VianneyRousset/IRemote/todo.md

# Vianney
- report:	Layout (direct upload), Intro/objectifs, Notation, Stages(schema)
- Kicad:	reception, decoding, relay 

# Michael
- report:	Stages, testing
- Kicad:	Encoder, (driver diode), filtering

# Report
- chaque stage est séparé en:
	1. Objectif et choix
	1. Implementation
	1. Dimensionnement
