VianneyRousset/IRemote/rapport/main.tex

\documentclass[french]{layout/Report}
\usepackage{layout/Report}
\usepackage{layout/ReportFrontPage}

\usepackage{pgf,tikz,textcomp}
\usepackage[section]{placeins}
\usepackage{romannum}
\usetikzlibrary{arrows}
\usepackage{mathtools}
\usepackage{array}
\usepackage{color}
\usepackage{graphicx}
\usepackage{todonotes}
\usepackage{enumitem}
\usepackage{MnSymbol} % rectangle symbol
\usepackage{pdfpages} % for appendix

\DeclarePairedDelimiter\abs{\lvert}{\rvert}%

\begin{document}

\pagenumbering{arabic}

\pagebreak

\frontpage{Télécommande à 1 canal par infrarouge}
%-------------------------------------------------------------------------------
\section{Introduction}
Le but est de concevoir un système d'émission - réception infrarouge avec adressage
permettant d'enclencher et déclencher un relais optique.

%-------------------------------------------------------------------------------
\section{Structure générale et principe}

Le système est divisé en 5 étages pour faciliter le développement et la testabilité:

\begin{description}[leftmargin=!,labelwidth=4cm, labelindent=\parindent]
	\item[Générateur de signal] Générateur de salves espacées de $\tau = \SI{100}{\milli\second}$ formée par $n_{pulse}$ impulsions de durée $t_0 =  \SI{100}{\micro\second}$ avec une période $T_0 = \SI{1}{\milli\second}$. 
\item[LED driver] Sortie de puissance qui contrôle la LED IR.
\item[Récepteur] Récepteur IR avec amplification et filtrage. La sortie est le signal digital des impulsions.
\item[Décodeur] Circuit logique de décodage du nombre d'impulsions. La sortie est une impulsion de $t_{true} = \SI{5}{\milli\second}$ pour chaque salve correcte reçue.
\item[Sortie] Circuit de détection d'interruption du signal avec commutation et du relais optique.
\end{description}

\begin{figure}[H]
\centering
\vspace{5mm}

\caption{Schéma bloc du système avec signaux}
\label{fig:schema_bloc}
\vspace{5mm}
\end{figure}

%-------------------------------------------------------------------------------
\section{Notation et nomenclature}

\begin{center}
	\begin{tabular}{| c | l | l |}
		\hline
		$n_{pulse}$	& Nombre d'impulsion dans une salve (addressage) & $13$ \\ \hline
		$t_0$				& Durée high d'une impulsion & $\SI{0.1}{\milli\second}$	\\ \hline
		$T_0$				& Période des impulsions& $\SI{1.0}{\milli\second}$	\\ \hline
		$D_0$				& Duty cycle dans une salve & $10\%$	\\ \hline
		$\tau$			& Période des slaves	& $\SI{0.1}{\second}$\\ \hline
		$t_{miss}$  & Durée pour la détection d'une impulsion manquante & $\SI{1.8}{\milli\second}$ \\ \hline
		$t_{true}$  & Durée signal une salve correcte & \SI{5}{\milli\second}\\ \hline
	\end{tabular}
\end{center}

\section{Dimensionnements}
\subsection{Signal}
Le nombre d'impulsions $n_{pulse}$ a été fixé arbitrairement à 13. La période et le duty-cycle des impulsions sont dictés par ce que la LED infrarouge peut supporter (c.f. \ref{subsec:LED_driver}).

\subsection{Générateur de signal}
Le générateur de signal génère dans OUTPUT des salves de $n_{pulses} = 13$ à une période $\tau = \SI{0.1}{\second}$ en active high tant que celui-ci est alimenté à 3V. Les impulsions dans les salves ont une durée high $t_0 = \SI{0.1}{\milli\second}$ et une période $T_0 = \SI{1.0}{\milli\second}$. Le nombre d'impulsions et les durées ne sont pas garanties lorsque l'alimentation est retirée.

\begin{description}[leftmargin=!,labelwidth=3cm, labelindent=\parindent]
	\item[Pulse timer]
        Génère des impulsions à hautes fréquences tant qu'il n'est pas RESET.
        Il est formé d'un timer TLC555 en configuration bascule astable.
        Les dimensionnements sont fait selon le datasheet \cite{TLC555} avec une capacité $\mathit{C16} = \SI{100}{\nano F}$ choisie petite pour la simplicité et la limitation de la consommation.
		\begin{equation*}
			\begin{cases}
				t_0 = 0.693(\mathit{R20}+\mathit{R23})\mathit{C16} \\
				T_0 = 0.693(\mathit{R20}+2\mathit{R23})\mathit{C16} \\
			\end{cases}
			\quad\Rightarrow\quad
			\begin{cases}
				\mathit{R20} = \SI{12}{\kilo\ohm} \\
				\mathit{R23} = \SI{1.5}{\kilo\ohm}
			\end{cases}
		\end{equation*}

        \begin{figure}[H]
        \centering
        
        \end{figure}

	\item[Down counter]
        Compte le nombre d'impulsions reçues depuis son dernier RESET et maintient le RESET du pulse timer le bloquant ainsi lorsque $n_{pulse}$ impulsions ont été reçues.
        Il est formé d'un compteur HEF4526B \cite{HEF4526B}.

	\item[Burst timer]
        Réinitialise le down counter à une période $\tau = \SI{0.1}{\second}$ pour recommencer une salve.
        Il est formé d'un timer TLC555 en configuration bascule astable.
        Les dimensionnements sont fait selon le datasheet \cite{TLC555} avec une capacité $\mathit{C10} = \SI{100}{\nano F}$ choisie petite pour la simplicité et la diminution de la consommation.
        La durée high doit être plus grand que la durée durée d'une salve.
		\begin{equation*}
			\begin{cases}
				\tau = 0.693(\mathit{R13}+2\mathit{R19})\mathit{C10} \\
				n_{pulse}*\frac{T_0}{\tau} < \frac{\mathit{R13}+\mathit{R19}}{\mathit{R13}+2\mathit{19}} \\
			\end{cases}
		\quad\Rightarrow\quad
			\begin{cases}
				\mathit{R13} = \SI{556}{\kilo\ohm} \\
				\mathit{R19} = \SI{467}{\kilo\ohm} \\
			\end{cases}
		\end{equation*}

        \begin{figure}[H]
        \centering
        
        \end{figure}

	\item[Logic]
        Assure les conditions logiques sur les signaux pour contrôler la sortie et arrêter le \textit{Pulse timer}.
        Il est formée d'un quadruple 2-input NOR HEF4001 \cite{HEF4001B}.
\end{description}

\subsection{LED driver}
\label{subsec:LED_driver}
Le LED driver allume la LED infrarouge lorsque LED\_SIGNAL est high. Il assure une bonne émission de la LED sans l'endommager si le signal de 3V a une période $T_0 = \SI{1}{\milli\second}$ avec un duty-cycle $D_0 = 10\%$.

La LED est une LD271(H). Selon son datasheet \cite{LD271(H)}, celle-ci accepte $\SI{1}{\ampere}$ durant $\SI{0.1}{\milli\second}$ toutes les $\SI{1.0}{\milli\second}$. Ce sont ses valeurs qui ont dicté le choix du signal. Le courant est limité par la résistance $\mathit{R14} = \SI{1}{\ohm}$. 
La tension au borne de la résistance $\mathit{R14}$ a été mesurée pour vérifier que le courant dans la LED ne dépasse pas $\SI{1}{\ampere}$.
L'alimentation se fait par le transistor NMOS IRLU8259\cite{IRLU8259} avec une faible tension Drain-Source.

La capacité de découplage est dimensionnée pour limiter la baisse de tension à 0.3V pendant une impulsion de durée $t_0 = \SI{0.1}{\milli\second}$ pour assurer la puissance de l'émission.
\begin{equation*}
	\mathit{C7} \ge \frac{I_{max}*t_0}{\Delta V_{max}} = \frac{\SI{1}{\ampere}*\SI{100}{\micro\second}}{\SI{0.3}{\volt}} = \SI{333}{\micro\farad} \Rightarrow \SI{470}{\micro\farad}
\end{equation*}

\begin{figure}[H]
\centering

\end{figure}

\subsection{Récepteur et filtrage}
Cet étage est composé de 3 sous-étages en série.

\begin{description}[leftmargin=!,labelwidth=3cm, labelindent=\parindent]
	\item[Convertisseur]
		La photodiode génère un petit courant qui est converti en une tension par l'amplificateur opérationnel LMC6482\cite{LMC6482}.
		La résistance $\mathit{R15}$ définit le gain et est assez élevée car le courant est relativement faible.
		Dans le conditions de test, une valeur de $\SI{1}{\mega\ohm}$ donnait les meilleures résultâts.
		En outre, la capacité $\mathit{C8} = \SI{10}{\pico\farad}$ filtre le bruit de haute fréquences d'ordre de $\SI{100}{\kilo Hz}$.

		\begin{figure}[H]
			\centering
			
		\end{figure}

	\item[Amplificateur]
        Le signal est ensuite amplifié par un facteur de $A = \mathit{R18}/\mathit{R17} = \SI{100}{\kilo\ohm}/\SI{10}{\kilo\ohm} = 10$.
        Avant l'amplification on filtre les fréquences parasites en dessous de $1/t_0 = 10kHz$ en utilisant un filtre passe-haut RC avec $\mathit{R16} = \SI{1}{\kilo\ohm}$ et $\mathit{C9} = \SI{100}{\nano\farad}$.

		\begin{figure}[H]
			\centering
			
		\end{figure}

	\item[Schmitt trigger]
        Génère un signal carré avec 2 seuils: $V_+ = \SI{1}{\milli\volt}$ et $V_- = \SI{10}{\milli\volt}$.
        Les valeurs de ces seuils ont été choisis pour correspondre à la tension après l'amplification et pour rejeter le bruit.
        Le choix des résistances ayant un degrés de liberté, celles-ci ont été choisies relativement grandes pour diminuer l'effet de la résistance pull-up $\mathit{R21}$.
        Le Schmitt trigger a été réalisé par le comparateur LM393 \cite{LM393} qui requiert une résistance de pull-up $\mathit{R21}$ de $\SI{10}{\kilo\ohm}$.
        	\begin{equation*}
    		\begin{cases}
    			V_- = \frac{1}{1+\frac{\mathit{R9}*\mathit{R11}}{\mathit{R10}*(\mathit{R9+\mathit{R11})}}}*\SI{5}{\volt} \\
    			V_+ = \frac{1}{1+\frac{\mathit{R9}*(\mathit{R10}+\mathit{R11})}{\mathit{R10}*\mathit{R11}}}*\SI{5}{\volt} \\
    		\end{cases}
    		\Rightarrow\quad
    		\begin{cases}
    			\mathit{R9}  = \SI{4.7}{\mega\ohm} \\
    			\mathit{R10} = \SI{10}{\kilo\ohm} \\
    			\mathit{R11} = \SI{4.7}{\mega\ohm} \\
    		\end{cases}
    		\end{equation*}

            \begin{figure}[H]
                \centering
                
            \end{figure}

	\item[Burst timer] Réinitialise le down counter à une période $\tau = \SI{0.1}{\second}$ pour recommencer une salve. Il est formé d'un timer TLC555 en configuration bascule astable. Les dimensionnements sont fait selon le datasheet \cite{TLC555} avec une capacité $\mathit{C10} = \SI{100}{\nano F}$ choisie petite pour la simplicité et la limitation de la consommation. La durée high doit être plus grand que la durée durée d'une salve.
		\begin{equation*}
			\begin{cases}
				\tau = 0.693(\mathit{R13}+2\mathit{R19})\mathit{C10} \\
				n_{pulse}*\frac{T_0}{\tau} < \frac{\mathit{R13}+\mathit{R19}}{\mathit{R13}+2\mathit{19}} \\
			\end{cases}
		\quad\
		\
	\end{equation*}

\end{description}

\subsection{Décodeur}
Le décodeur à 3 fonctions:

\begin{description}[leftmargin=!,labelwidth=4cm, labelindent=\parindent]
	\item[Down counter]
        Signale si $n_{pulse}$ impulsions ont été reçues depuis son dernier RESET.
        Il formé du compteur 4bit HEF4526B \cite{HEF4526B}.

	\item[Missing pulse detector]
        Signal et reset le down counter après un certain $t_{true} = \SI{5}{\milli\second}$ délais si la tension d'entrée est maintenue \emph{high} pendant au moins $t_{miss} = \SI{1.8}{\milli\second}$ après la fin d'une impulsion.
        La durée $t_{miss}$ a été arbitrairement choisie pour être supérieur à $t_0 = \SI{1}{\milli\second}$ mais inférieur à $2t_0$.
        Les dimensionnements sont fait selon le datasheet \cite{TLC555} avec une capacité $\mathit{C3} = \SI{100}{\nano F}$ choisie petite pour la simplicité et la limitation de la consommation.

		\begin{equation*}
			t_{miss} = \mathit{R7}*\mathit{C3} \quad\Rightarrow\quad \mathit{R7} = \SI{18}{\kilo\ohm}
		\end{equation*}

		\begin{figure}[H]
			\centering
			
		\end{figure}

	\item[Logic]
        Met OUTPUT à high si les conditions d'une salve correcte sont remplie.
        Si $n_{pulse}$ impulsions ont été reçues et que une impulsion manquante est signalée, alors OUTPUT est mis à high.

        La logique de sortie est réalisée en NOR gate comme suivant:
        \begin{align*}
        \text{Sortie} & = \text{"bon nombre d'impulsions"} \land \text{"fin de salve"} \\
        & = \overline{\overline{\text{"bon nombre d'impulsions"}} \lor \overline{\text{"fin de salve"}}}
        \end{align*}

        \begin{figure}[H]
            \centering
            
        \end{figure}

        La sortie du \textit{Missing pulse detector} est relié à l'entrée de RESET \textit{Down counter}
        à travers un détecteur de flanc déscendant et un circuit de délai réalisé par des gate NOR et des filtres RC.
        Les valeurs de R et C ont été choisi pour avoir un délai et un pulse de RESET d'ordre de $\SI{10}{\kilo\ohm}*\SI{100}{\nano\farad} = \SI{1}{\milli\second}$.
        \begin{figure}[H]
            \centering
            
        \end{figure}

\end{description}

\subsection{Sortie}

\begin{description}[leftmargin=!,labelwidth=4cm, labelindent=\parindent]
	\item[Détecteur d'interruption]
        Une interruption des pulses sortant du décodeur signifie un déclenchemnt du bouton de la télécommande.
        La bascule monostable HEF4538 détecte une absence de pulse pendant $T = 1.5 \tau = \SI{150}{\milli\second} = R_{EXT}*C_{EXT}$ (voir datasheet \cite{HEF4538}).
        Le signal de sortie est high quand un signal périodique est reçu, ce qui correspond à l'étât du bouton sur la télécommande.
        \begin{equation*}
            \mathit{C6}*\mathit{R12} = \SI{150}{\milli\second}
            \Rightarrow\quad
            \begin{cases}
                \mathit{C6} = \SI{100}{\nano\farad} \\
                \mathit{R12} = \SI{150}{\kilo\ohm}
            \end{cases}
        \end{equation*}

        \begin{figure}[H]
        \centering
        
        \end{figure}

    \item[Commutateur]
        La commutation de la sortie pour chaque nouveau appui sur le bouton est réalisé par le D-flip-flop HEF4013\cite{HEF4013}.
        Le signal du \textit{Détecteur d'interruption} est branché sur la clock $CP$ et la sortie inversé $\overline{Q}$ sur l'entrée de donnée $D$.
        Donc chaque appui sur le bouton génère un flanc montant sur la clock et l'état de la sortie est ensuite inversé.
        (voir mesure \ref{fig:output_signal})

        \begin{figure}[H]
        \centering
        
        \end{figure}

	\item[Relais] Le relais optique est simulé par une LED rouge standard avec un courant de \SI{20}{\milli\ampere} et une tension directe d'environ \SI{1.8}{\volt}. Pour alimenter la LED on a choisi le transistor bipolaire NPN BC107 avec une résistance en série pour limiter le courant.
		Le BC107 a une tension \(V_{CEsat}\) de \SI{0.25}{\volt} pour un courant de \SI{10}{\milli\ampere}.
		En estimant une \(V_{CEsat}\) de \SI{0.30}{\volt} pour un courant de \SI{20}{\milli\ampere}:
        \begin{equation*}
        R_{LED} = (5V - V_{CEsat} - V_{forward})/\SI{20}{\milli\ampere} = \SI{145}{\ohm} \Rightarrow \SI{150}{\ohm}
        \end{equation*}
        % \begin{figure}[H]
        % \centering
        % \includegraphics[width=0.2\textwidth]{fig/output_led.pdf}
        % \end{figure}

\end{description}
\subsection{Mesures}

Figure \ref{fig:filter_signal} montre l'évolution du signal à travers l'es étages d'amplification du récepteur.

\begin{figure}[H]
\centering
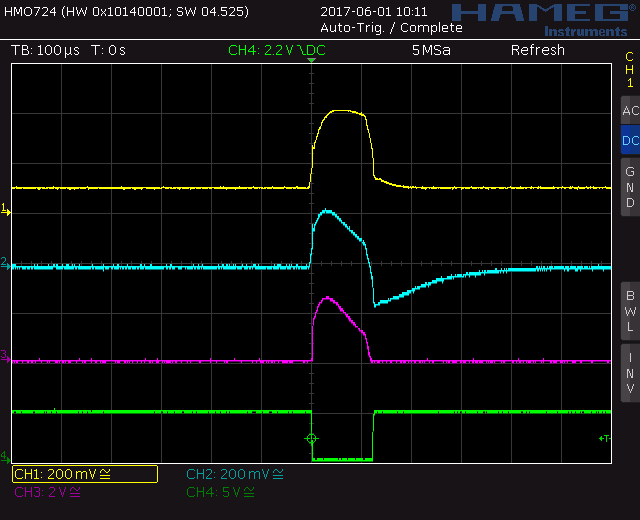
[picture p1: measurements/SCR03.PNG]

\caption{
\textcolor{yellow}{$\blacksquare$} Conversion courant-tension,
\textcolor{blue}{$\blacksquare$} Filtre passe-haut,
\textcolor{magenta}{$\blacksquare$} Signal 10x amplifié,
\textcolor{green}{$\blacksquare$} Schmitt trigger output
}
\label{fig:filter_signal}
\end{figure}

Dans figure \ref{fig:decoder_signal} on voit le fonctionnement du détecteur avec différent nombres d'impulsions.
Dans la mesure au milieu le décodeur détecté correctement les 13 impulsions et la combinaison logique
du signal du détecteur d'impulsion manquant et du compteur d'impulsion donne un signal de sortie (en vert).
Dans le cas où le mauvais nombre  d'impulsions (12 impulsions dans la mesure à gauche et 14 impulsions à droite)
arrive à l'entrée il n'y a pas de signal à la sortie.

\begin{figure}[H]
\centering
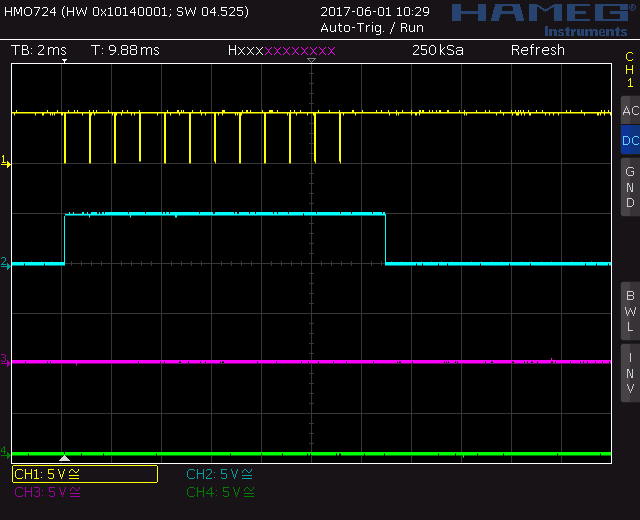
[picture p2: measurements/SCR06.PNG]

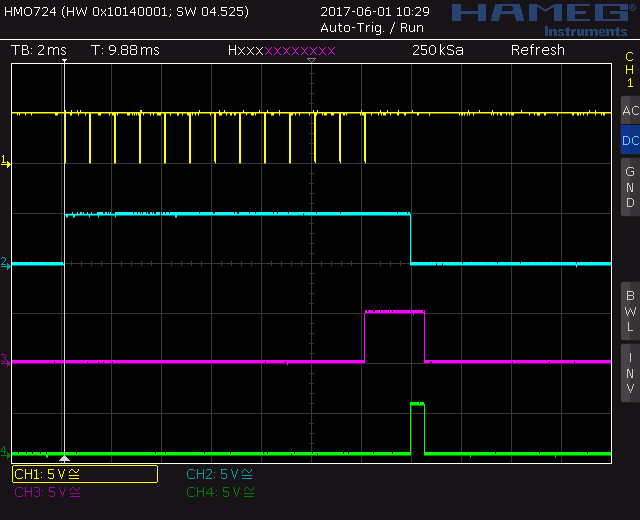
[picture p3: measurements/SCR07.PNG]

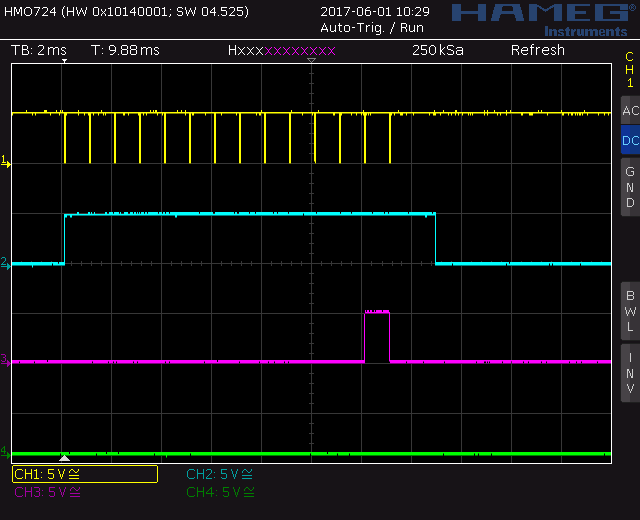
[picture p4: measurements/SCR08.PNG]

\caption{
\textcolor{yellow}{$\blacksquare$} Signal d'entrée,
\textcolor{blue}{$\blacksquare$} Détecteur d'impulsion manquant,
\textcolor{magenta}{$\blacksquare$} Compteur d'impulsions,
\textcolor{green}{$\blacksquare$} Sortie
}
\label{fig:decoder_signal}
\end{figure}

\begin{figure}[H]
\centering
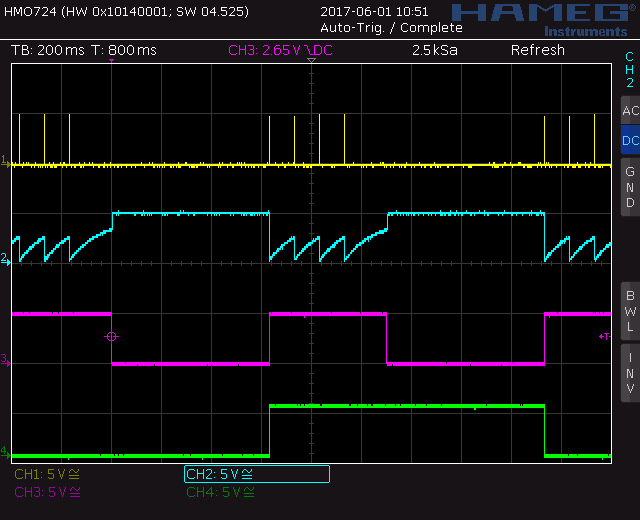
[picture p5: measurements/SCR12.PNG]

\caption{
\textcolor{yellow}{$\blacksquare$} Signal du décodeur,
\textcolor{blue}{$\blacksquare$} Capacité sur bascule monostable,
\textcolor{magenta}{$\blacksquare$} Détecteur d'interruption (état du bouton),
\textcolor{green}{$\blacksquare$} Relais
}
\label{fig:output_signal}
\end{figure}

\begin{thebibliography}{9}

	\bibitem{LD271(H)}
	OSRAM,
	\textit{LD271 - HGaAs Infrared Emitter},
	Version 1.0,
	4 Avril 2007,
	\url{http://www.osram-os.com/Graphics/XPic5/00082753_0.pdf/LD%20271,%20Lead%20(Pb)%20Free%20Product%20-%20RoHS%20Compliant.pdf}

		\bibitem{BP104}
		VISHAY,
		\textit{BP104 - Silicon PIN Photodiode},
		Revision: 08-Feb-17,\\
		\url{http://www.vishay.com/docs/81500/81500.pdf}

		\bibitem{TLC555}
		TEXAS INSTRUMENTS,
		\textit{TLC555 LinCMOS\texttrademark Timer},
		REVISED AUGUST 2016,
		SEPTEMBER 1983,\\
		\url{http://www.ti.com/lit/ds/symlink/tlc555.pdf}

		\bibitem{HEF4526B}
		NXP,
		\textit{HEF4526B - Programmable 4-bit binary down counter - Product data sheet},
		Rev. 5,
		22 November 2011,\\
		\url{http://www.nxp.com/documents/data_sheet/HEF4526B.pdf}.

		\bibitem{HEF4001B}
        NXP,
        \textit{HEF4001B - Quad 2-input NOR gate - Product data sheet},
        Rev. 10,
        10 December 2015,\\
        \url{https://assets.nexperia.com/documents/data-sheet/HEF4001B.pdf}

        \bibitem{IRLU8259}
        International Rectifier,
        \textit{IRLU8259PbF - HEXFET\textregistered Power MOSFET},
        PD - 97360,
        16 December 2008,\\
        \url{http://www.infineon.com/dgdl/irlr8259pbf.pdf?fileId=5546d462533600a40153566e1ebe26e9}

        \bibitem{LMC6482}
        Texas Instruments,
        \textit{LMC6482 CMOS Dual Rail-to-Rail Input and Output Operational Amplifier},
        SNOS674E,
        April 2015,\\
        \url{http://www.ti.com/lit/ds/symlink/lmc6482.pdf}

        \bibitem{LM393}
		Texas Instruments,
		\textit{LMx93-N, LM2903-N Low-Power, Low-Offset Voltage, Dual Comparators},
		SNOSBJ6F,
		December 2014,\\
		\url{http://www.ti.com/lit/ds/symlink/lm393-n.pdf}

        \bibitem{HEF4538}
        Nexperia,
        \textit{HEF4538B Dual precision monostable multivibrator},
        Rev. 10,
        April 2016,\\
        \url{https://assets.nexperia.com/documents/data-sheet/HEF4538B.pdf}

        \bibitem{HEF4013}
        Nexperia,
        \textit{HEF4013B Dual D-type flip-flop},
        Rev. 9,
        December 2015,\\
        \url{https://assets.nexperia.com/documents/data-sheet/HEF4013B.pdf}
\end{thebibliography}

\includepdf[pages={-},angle=90,scale=0.95,pagecommand={}]{../schema/IRemote.pdf}

\end{document}
