VianneyRousset/IRemote/measurements/SCR01.PNG

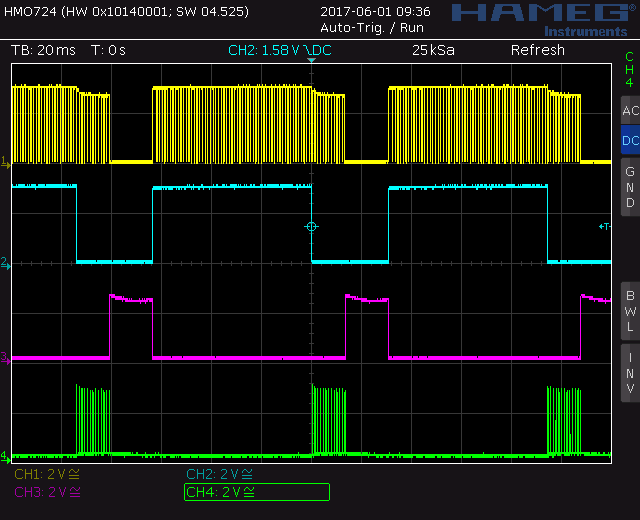
measurements/SCR01.PNG
