VianneyRousset/IRemote/measurements/SCR04.PNG

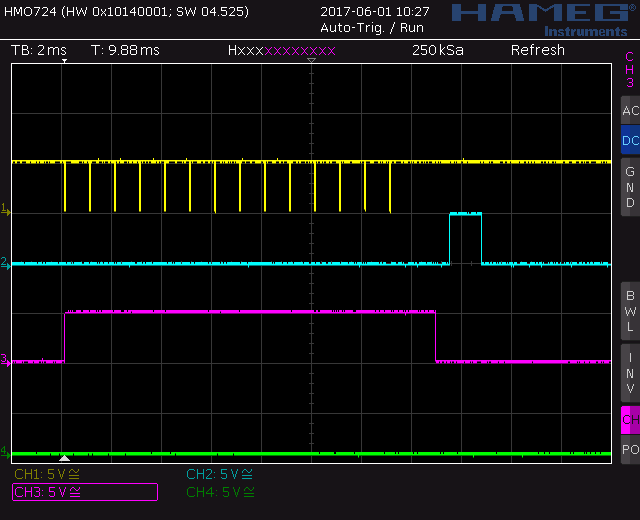
measurements/SCR04.PNG
