VianneyRousset/IRemote/measurements/SCR05.PNG

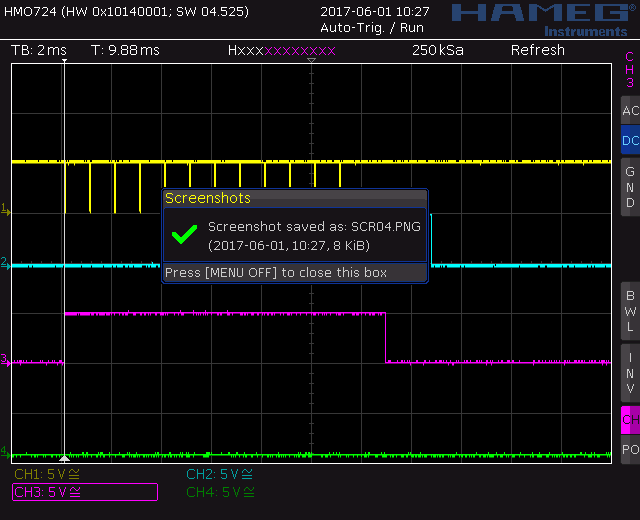
measurements/SCR05.PNG
