VianneyRousset/IRemote/measurements/SCR09.PNG

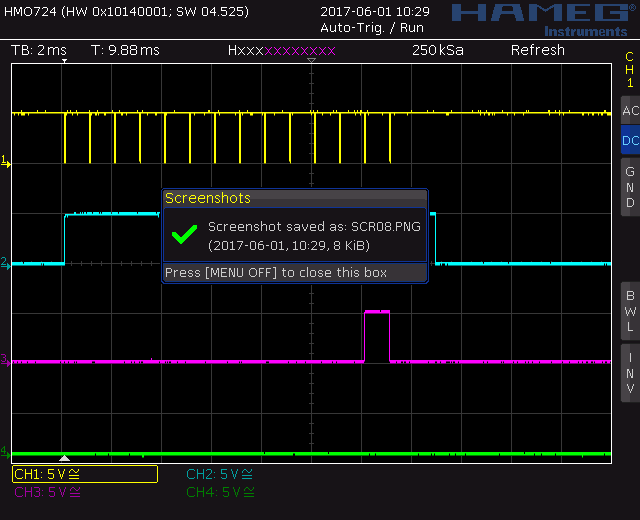
measurements/SCR09.PNG
