VianneyRousset/IRemote/measurements/SCR10.PNG

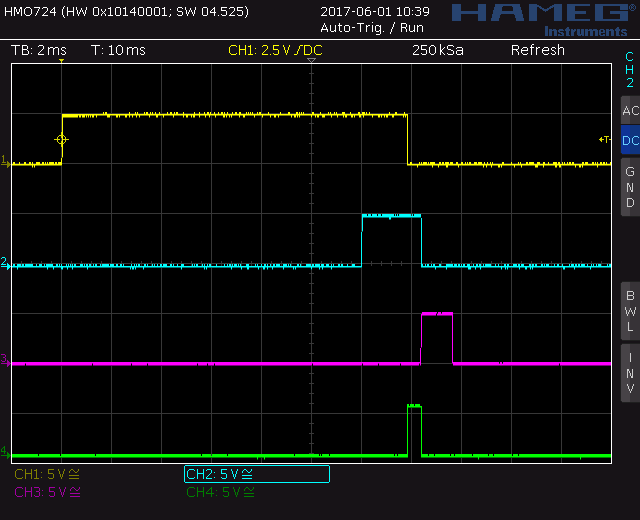
measurements/SCR10.PNG
