VianneyRousset/IRemote/measurements/SCR11.PNG

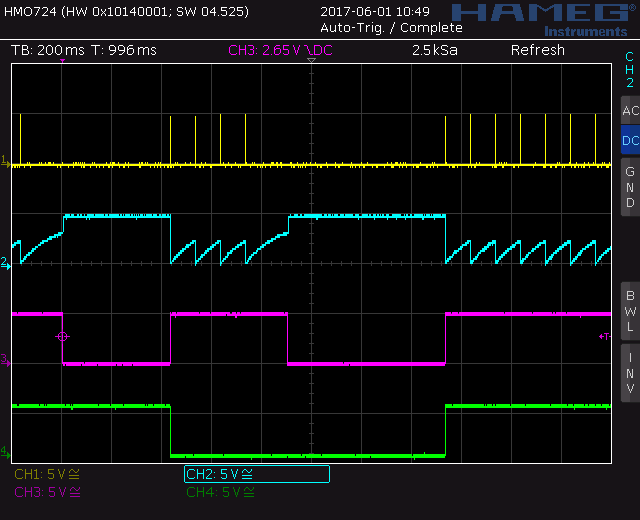
measurements/SCR11.PNG
