VianneyRousset/IRemote/measurements/debug/SCR02.PNG

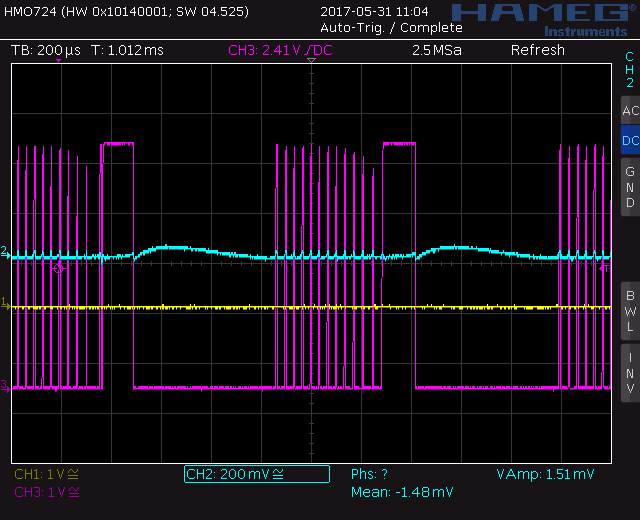
measurements/debug/SCR02.PNG
