VianneyRousset/IRemote/measurements/debug/SCR03.PNG

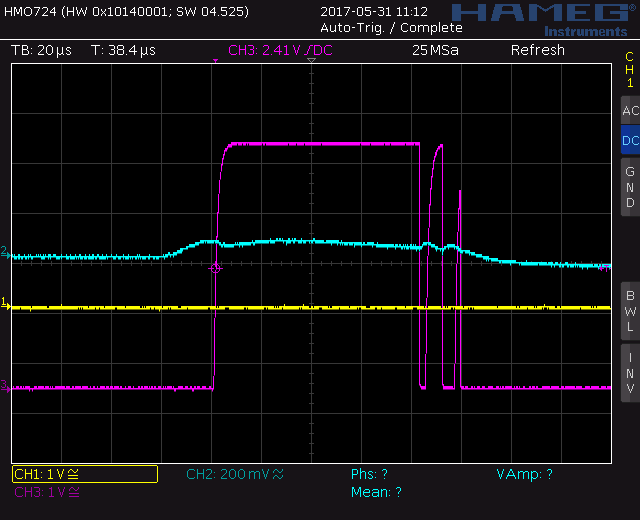
measurements/debug/SCR03.PNG
