VianneyRousset/IRemote/measurements/debug/SCR04.PNG

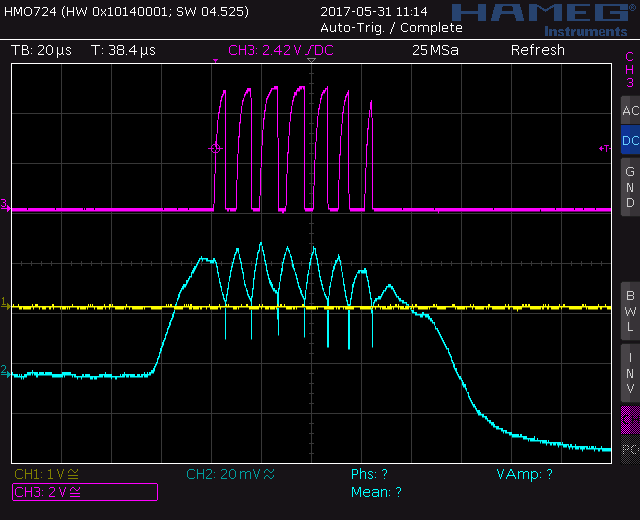
measurements/debug/SCR04.PNG
