VianneyRousset/IRemote/measurements/debug/SCR05.PNG

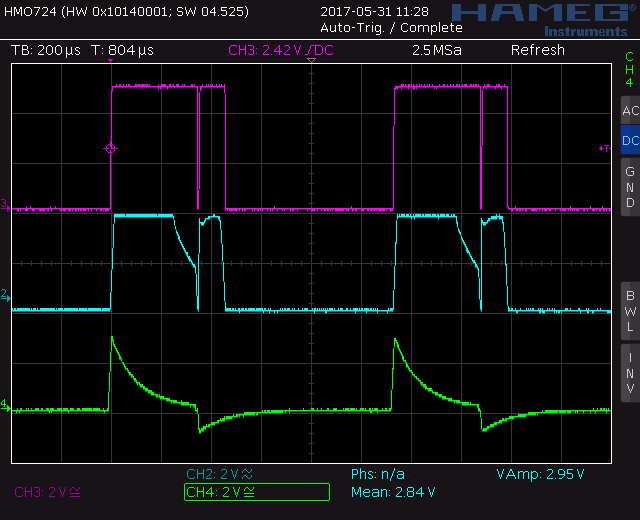
measurements/debug/SCR05.PNG
