VianneyRousset/IRemote/measurements/debug/SCR06.PNG

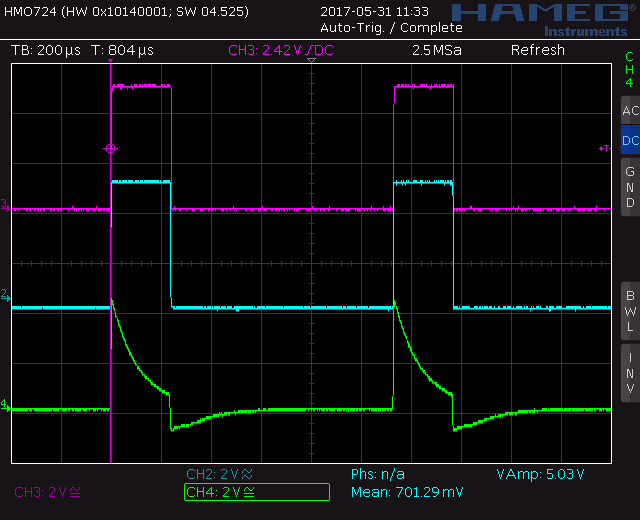
measurements/debug/SCR06.PNG
