VianneyRousset/IRemote/measurements/debug/SCR07.PNG

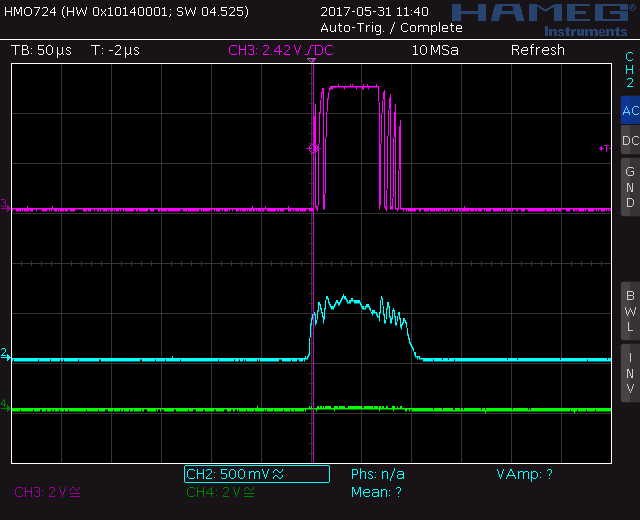
measurements/debug/SCR07.PNG
