VianneyRousset/IRemote/measurements/debug/SCR08.PNG

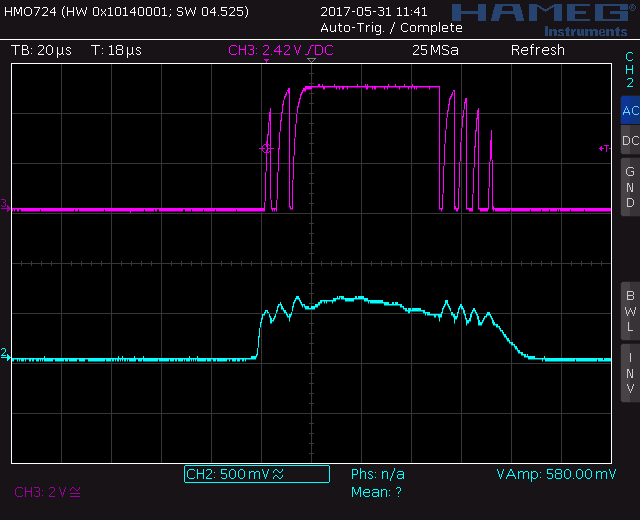
measurements/debug/SCR08.PNG
