VianneyRousset/IRemote/measurements/debug/SCR10.PNG

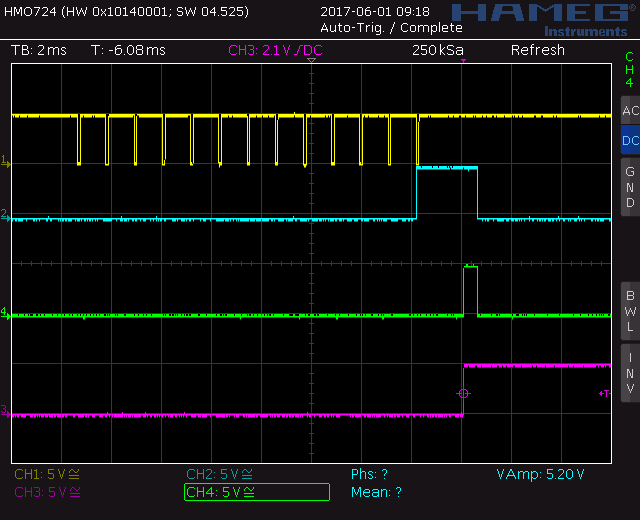
measurements/debug/SCR10.PNG
