VianneyRousset/IRemote/rapport/fig/decoder_output_logic.pdf

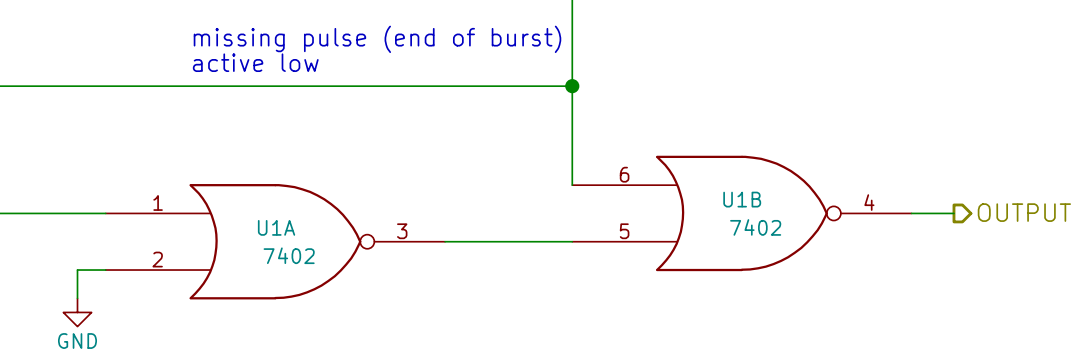
[picture p20: page 1]
GND; OUTPUT

Authors: Vianney Rousset, Michael Spieler GND 1

missing pulse (end of burst)
active low
