VianneyRousset/IRemote/rapport/fig/schmitt_trigger.pdf

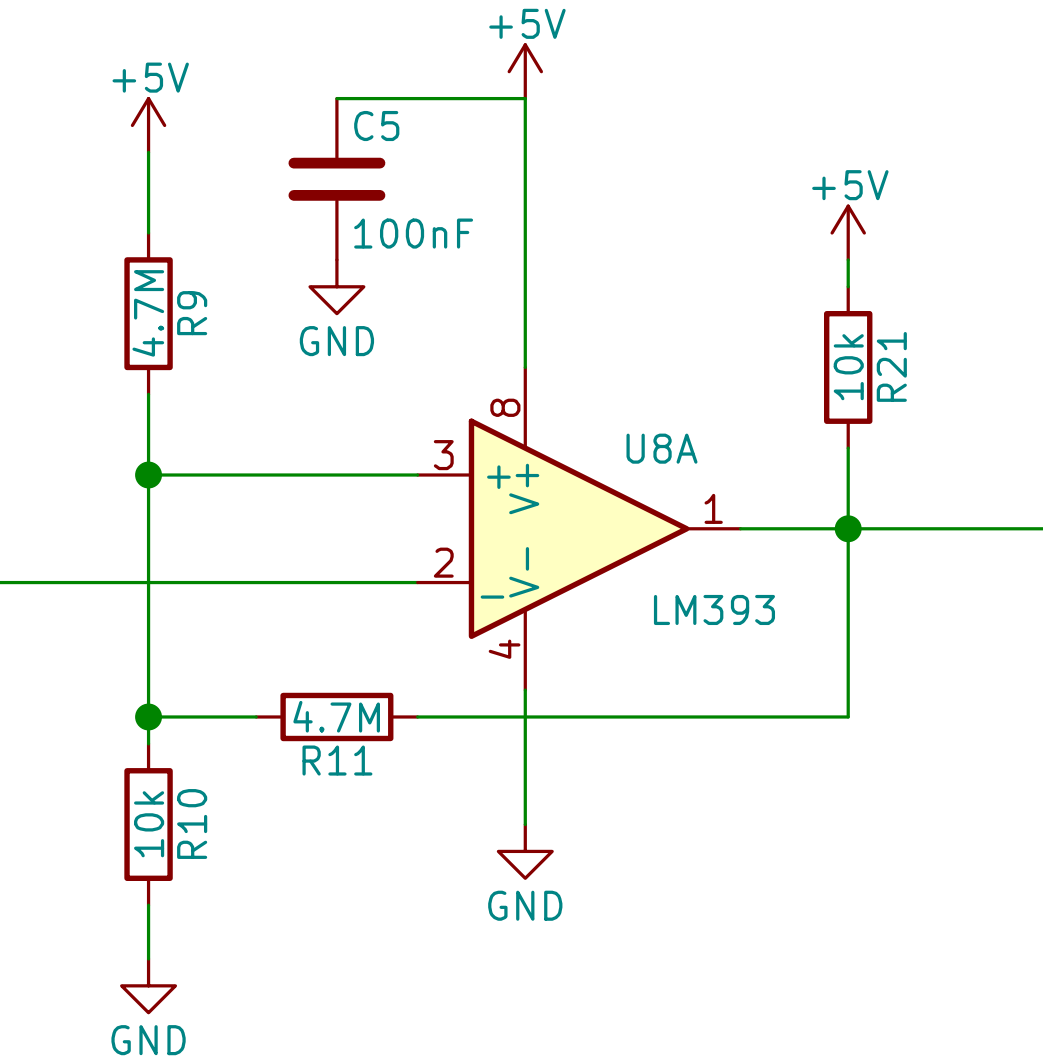
[picture p21: page 1]
GND
