VianneyRousset/IRemote/rapport/fig/missing_pulse_detector.pdf

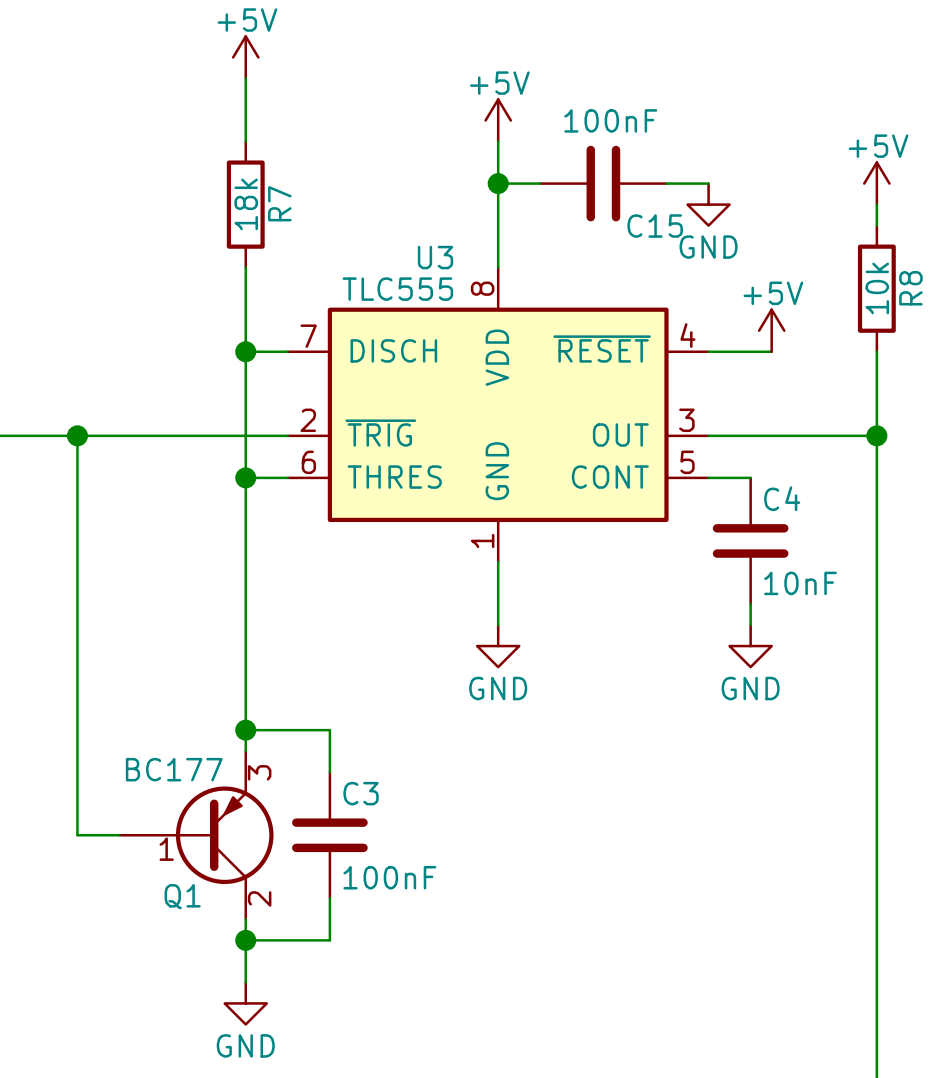
[picture p22: page 1]
TRIG 2; OUT 3; RESET 4; CONT 5 THRES 6; DISCH 7; VDD 8; U3 TLC555; GND

Authors: Vianney Rousset, Michael Spieler GND 1
