VianneyRousset/IRemote/rapport/fig/pulse_timer.pdf

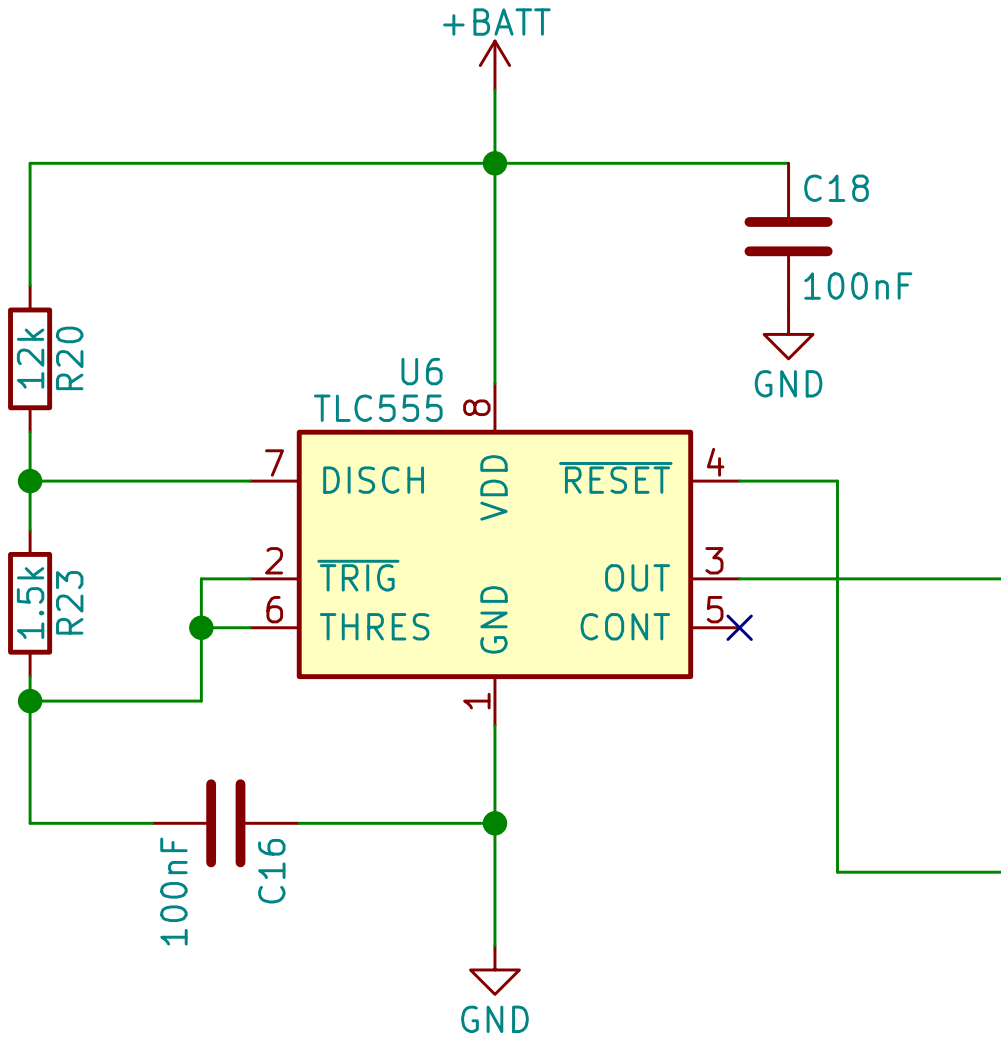
[picture p24: page 1]
GND 1; TRIG 2; OUT 3; RESET 4; CONT 5 THRES 6; DISCH 7; VDD 8; U6 TLC555; +BATT; GND
