VianneyRousset/IRemote/rapport/out/main.pdf

### (EE-380) ELECTRONIQUE, LABO

RAPPORT

# Télécommande à 1 canal par infrarouge

Auteurs:
SPIELER Michael
ROUSSET Vianney

Professeur:
DÉCURNEX André

13 juin 2017

## 1 Introduction

Le but est de concevoir un système d’émission - réception infrarouge avec adressage permettant d’enclen-cher et déclencher un relais optique.

## 2 Structure générale et principe

Le système est divisé en 5 étages pour faciliter le développement et la testabilité :

Générateur de signal | Générateur de salves espacées de τ = 100ms formée par npulse impulsions de durée t0 = 100µs avec une période T0 = 1ms.
LED driver | Sortie de puissance qui contrôle la LED IR.
Récepteur | Récepteur IR avec amplification et filtrage. La sortie est le signal digital des impulsions.
Décodeur | Circuit logique de décodage du nombre d’impulsions. La sortie est une impul- sion de ttrue = 5ms pour chaque salve correcte reçue.
Sortie | Circuit de détection d’interruption du signal avec commutation et du relais optique.

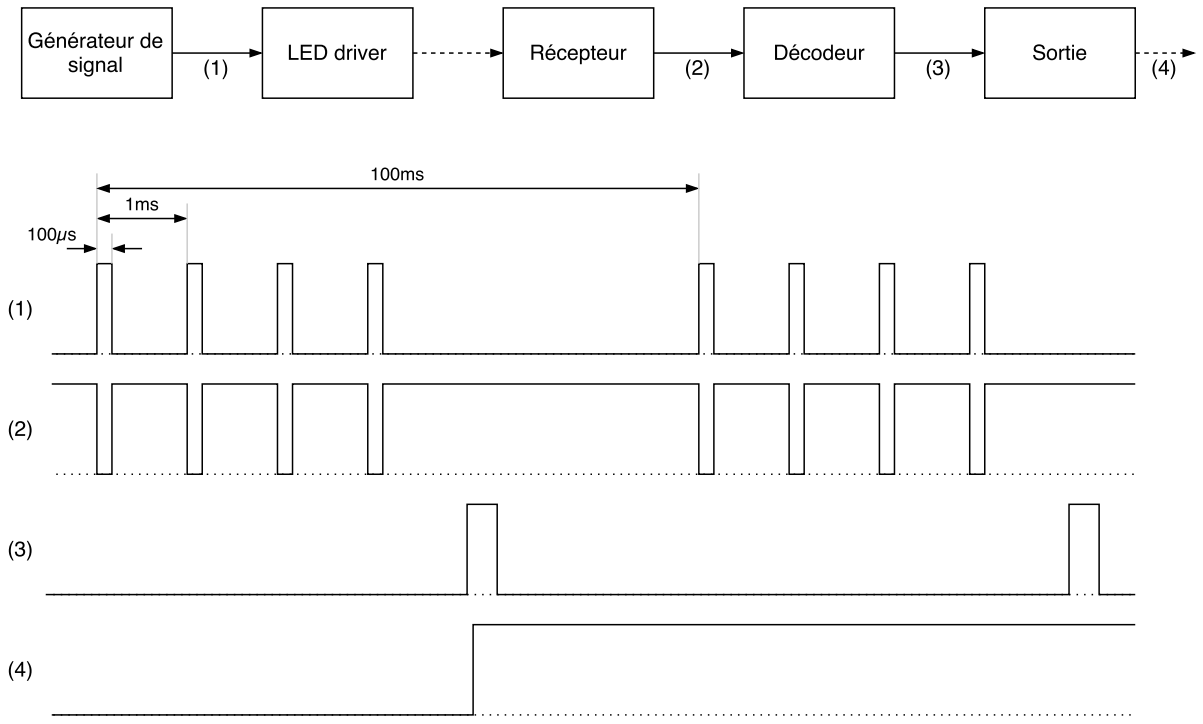
[picture p25: figure]

FIGURE 1 – Schéma bloc du système avec signaux

## 3 Notation et nomenclature

npulse | Nombre d’impulsion dans une salve (addressage) | 13
t0 | Durée high d’une impulsion | 0.1ms
T0 | Période des impulsions | 1.0ms
D0 | Duty cycle dans une salve | 10%
τ | Période des slaves | 0.1 s
tmiss | Durée pour la détection d’une impulsion manquante | 1.8ms
ttrue | Durée signal une salve correcte | 5 ms

## 4 Dimensionnements

### 4.1 Signal

Le nombre d’impulsions npulse a été fixé arbitrairement à 13. La période et le duty-cycle des impulsions sont dictés par ce que la LED infrarouge peut supporter (c.f. 4.3).

### 4.2 Générateur de signal

Le générateur de signal génère dans | OUTPUT des | salves de npulses = 13 à une | période τ = 0.1 s en active
high tant que celui-ci est alimenté | à 3V. | Les impulsions dans les salves ont une durée high t0 = 0.1ms et une
période T0 = 1.0ms. Le nombre d’impulsions et les durées ne sont pas garanties | lorsque l’alimentation est
retirée.
Pulse timer | Génère des impulsions à hautes fréquences tant qu’il n’est pas RESET. Il est formé
d’un timer TLC555 en configuration bascule astable. Les dimensionnements sont fait selon le datasheet [3] avec une capacité C16 = 100nF choisie petite pour la simplicité et la limitation de la consommation.

⎧⎪⎪
⎨

⎪⎪⎩

t0 = 0.693(R20+R23)C16
T0 = 0.693(R20+2R23)C16
| | ⇒ ⎧⎪⎪
⎨
| | ⎪⎪⎩

R20 = 12kΩ
R23 = 1.5kΩ

C

GND 1

TRIG 2 | OUT 3

RESET 4

CONT 5 THRES 6

DISCH 7

VDD 8

U6
TLC555

+BATT

1.5k

R23

GND

12k

R20

C16
100nF

C18

100nF

GND

Down counter | Compte le nombre d’impulsions reçues depuis son dernier RESET et maintient le RESET du pulse timer le bloquant ainsi lorsque npulse impulsions ont été reçues. Il est formé d’un compteur HEF4526B [4].
Burst timer | Réinitialise le down counter à une période τ = 0.1 s pour recommencer une salve. Il est formé d’un timer TLC555 en configuration bascule astable. Les dimensionnements sont fait selon le datasheet [3] avec une capacité C10 = 100nF choisie petite pour la simplicité et la diminution de la consommation. La durée high doit être plus grand que la durée durée d’une salve.
| ⎧⎪⎪
⎨
| ⎪⎪⎩ τ = 0.693(R13+2R19)C10
| npulse ∗ T0 τ < R13+R19 R13+219 ⇒ ⎧⎪⎪
⎨
| ⎪⎪⎩ R13 = 556kΩ R19 = 467kΩ

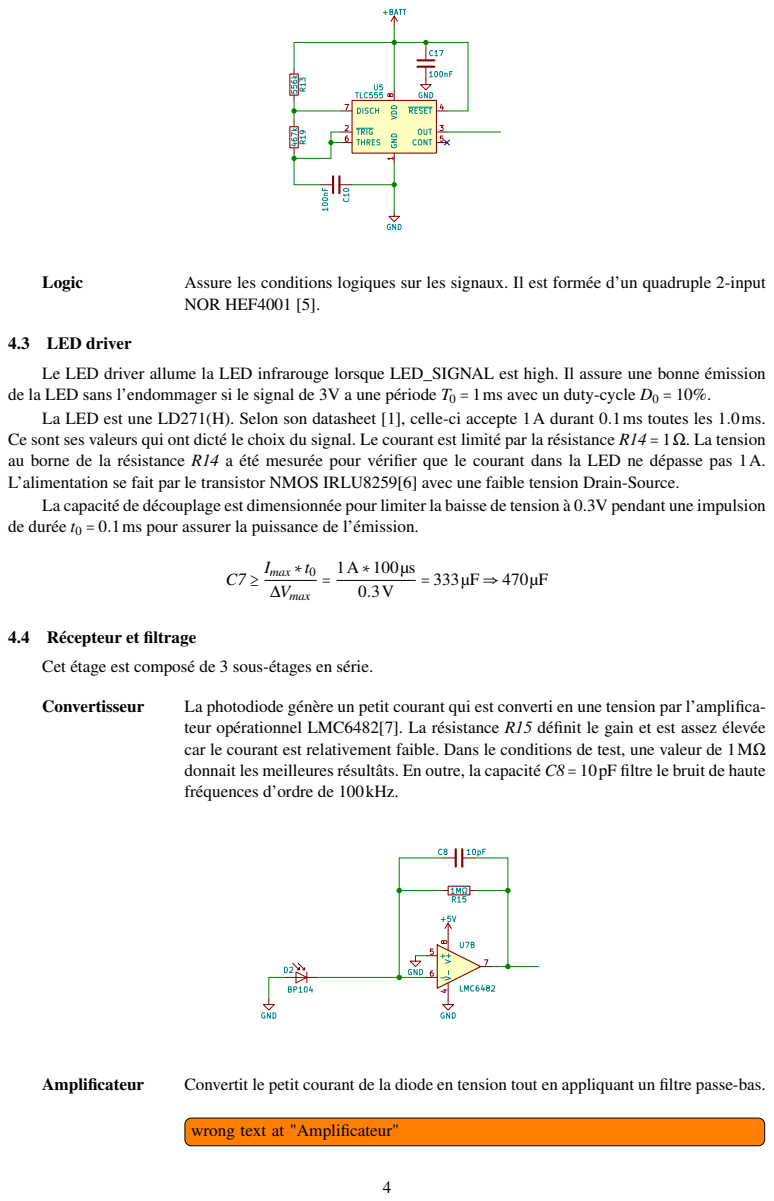
[picture p26: page 4]

de la LED sans l’endommager si le signal de 3V a une période T0 = 1ms avec un duty-cycle D0 = 10%.
Ce sont ses valeurs qui ont dicté le choix du signal. Le courant est limité par la résistance R14 = 1Ω. La tension
L’alimentation se fait par le transistor NMOS IRLU8259[6] avec une faible tension Drain-Source.
La capacité de découplage est dimensionnée pour limiter la baisse de tension à 0.3V pendant une impulsion
de durée t0 = 0.1ms pour assurer la puissance de l’émission.

Cet étage est composé de 3 sous-étages en série.

teur opérationnel LMC6482[7]. La résistance R15 définit le gain et est assez élevée
car le courant est relativement faible. Dans le conditions de test, une valeur de 1MΩ
donnait les meilleures résultâts. En outre, la capacité C8 = 10pF filtre le bruit de haute
fréquences d’ordre de 100kHz.

wrong text at "Amplificateur"

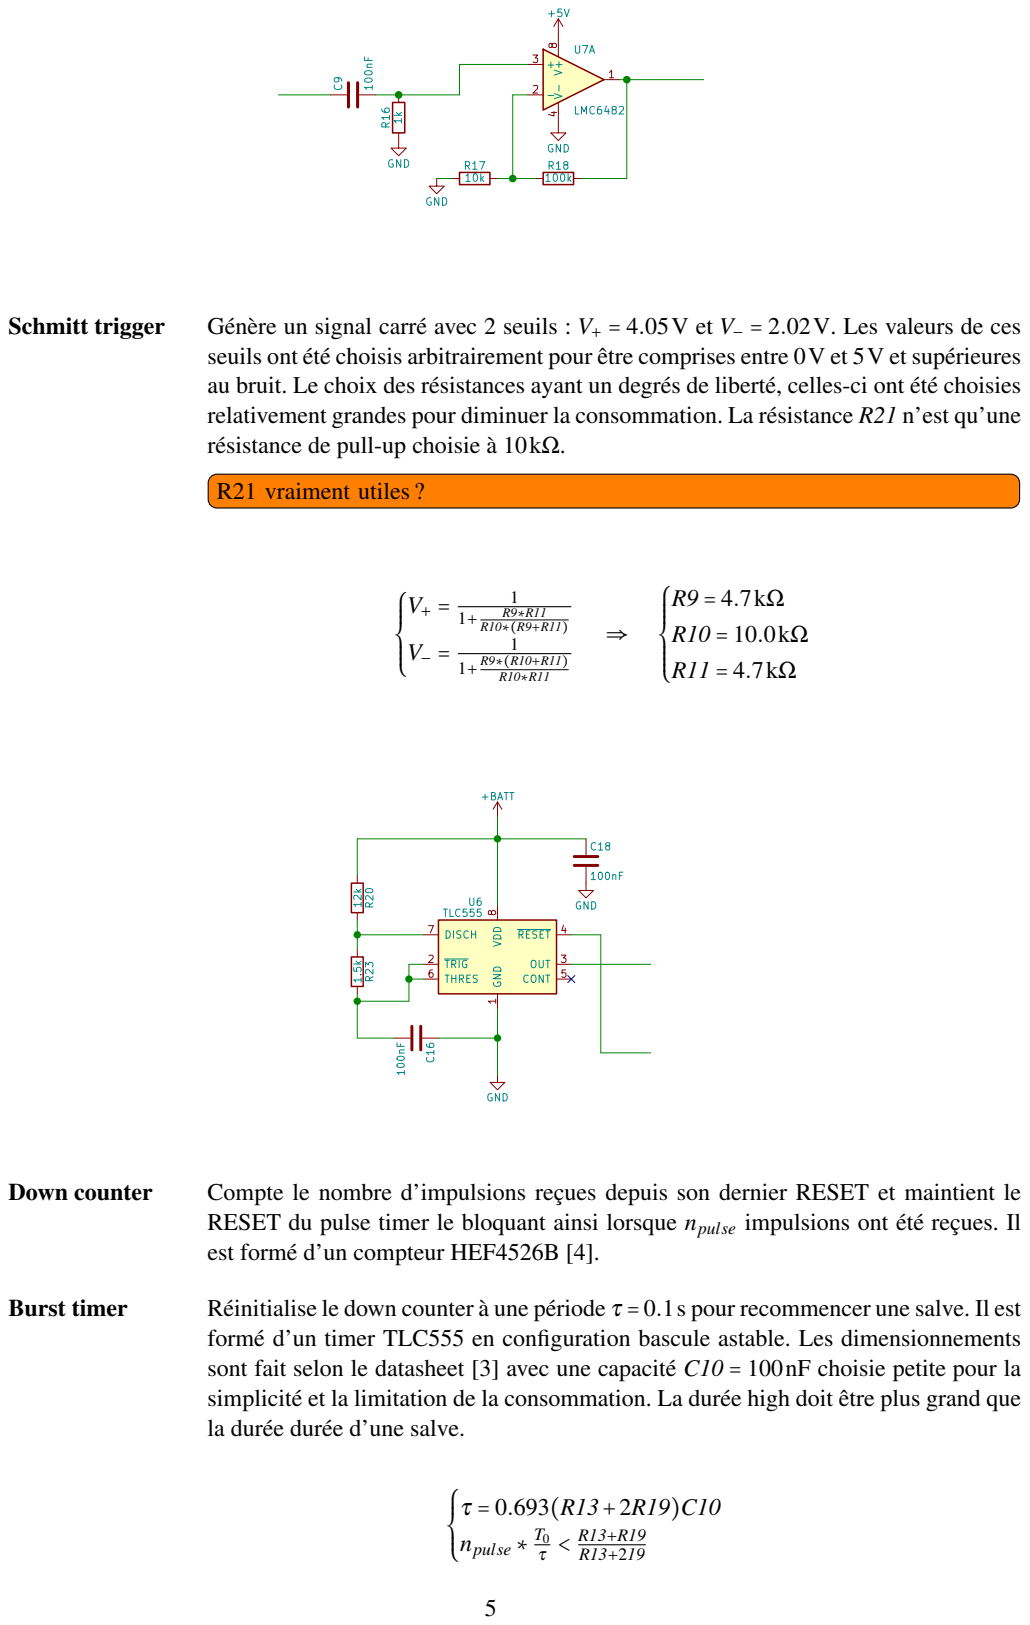
[picture p27: page 5]

seuils ont été choisis arbitrairement pour être comprises entre 0V et 5V et supérieures
au bruit. Le choix des résistances ayant un degrés de liberté, celles-ci ont été choisies
relativement grandes pour diminuer la consommation. La résistance R21 n’est qu’une
résistance de pull-up choisie à 10kΩ.

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

formé d’un timer TLC555 en configuration bascule astable. Les dimensionnements
sont fait selon le datasheet [3] avec une capacité C10 = 100nF choisie petite pour la
simplicité et la limitation de la consommation. La durée high doit être plus grand que
la durée durée d’une salve.

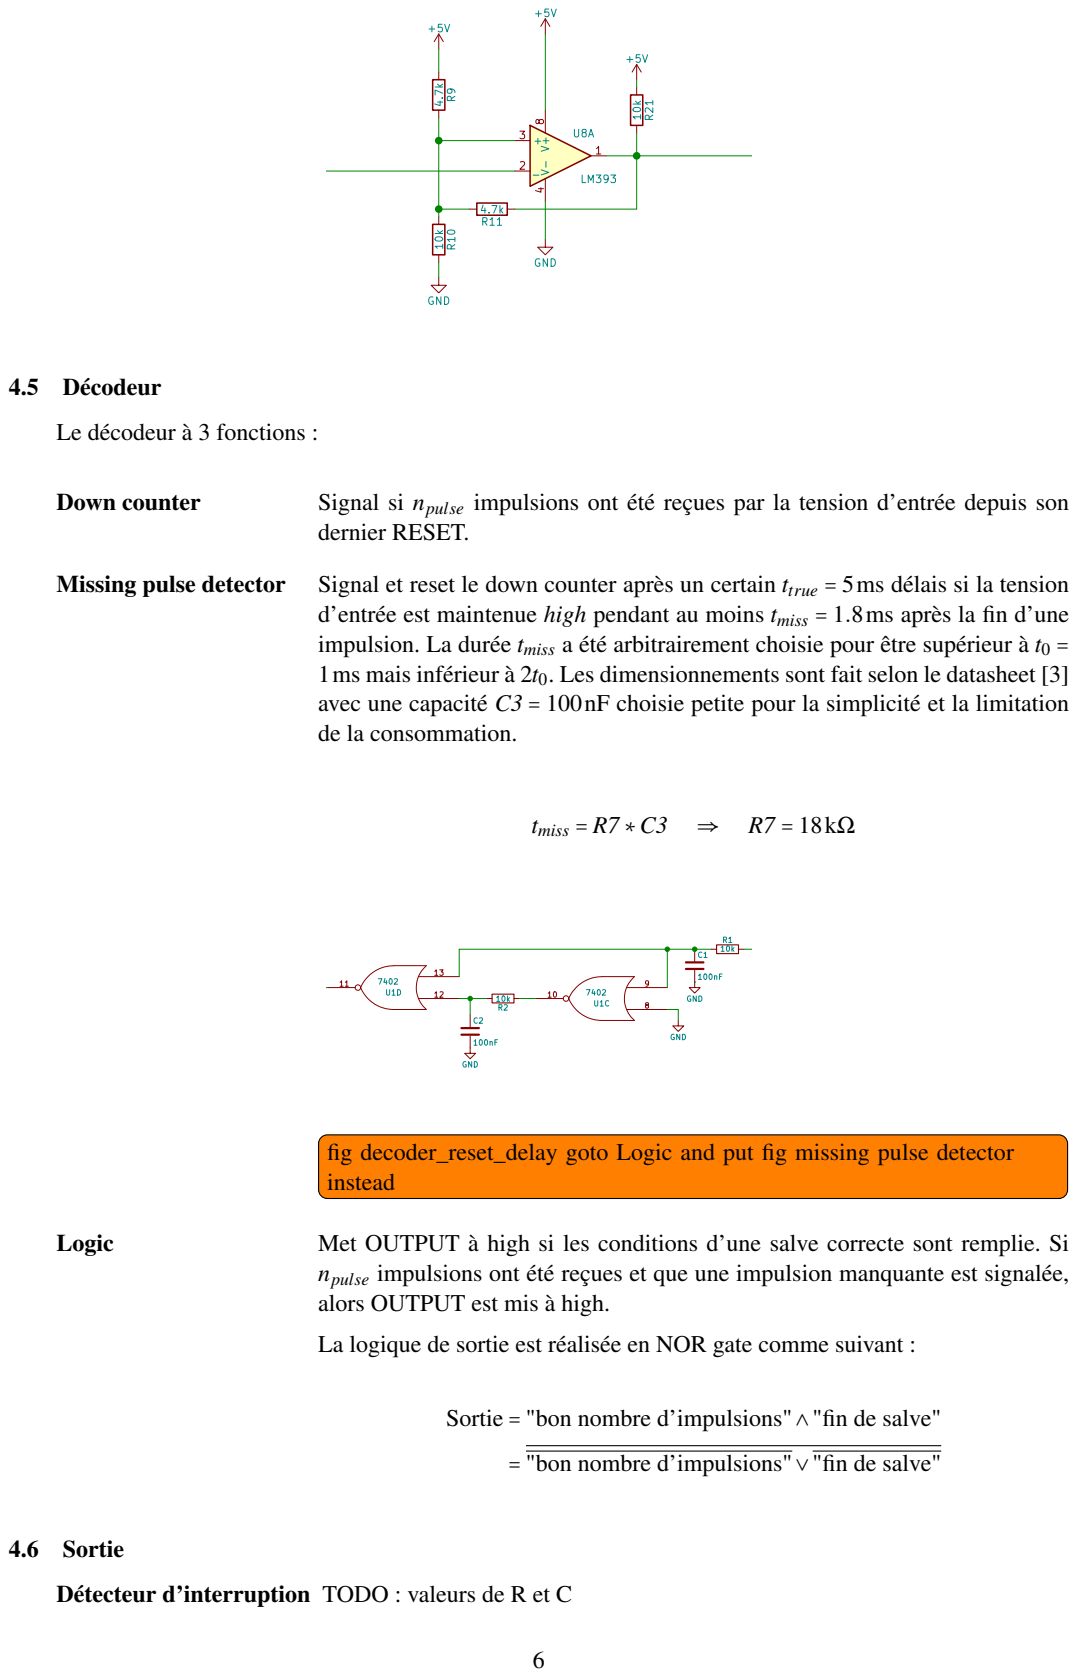
[picture p28: page 6]

1ms mais inférieur à 2t0. Les dimensionnements sont fait selon le datasheet [3]
de la consommation.

fig decoder_reset_delay goto Logic and put fig missing pulse detector
instead

npulse impulsions ont été reçues et que une impulsion manquante est signalée,
alors OUTPUT est mis à high.
La logique de sortie est réalisée en NOR gate comme suivant :

Sortie = "bon nombre d’impulsions"∧"fin de salve"

= "bon nombre d’impulsions"∨"fin de salve"

Détecteur d’interruption TODO : valeurs de R et C

DRIVER_INPUT

C6

100nF

150k
R12

+5V

+5V

+5V

GND

C11

100nF

GND

VSS | 8
VDD | 16
CEXT 1 | REXT/CEXT 2

CD 3

B 4 | A 5 | Q | 6
| | Q | 7

U4A

HEF4538

Commutateur | TODO : Ce D-flip-flop qui toggle la LED chaque flanc montant...
Relais | Le relais optique est simulé par une LED rouge standard avec un courant de 20 mA et une tension directe d’environ 1.8 V. Pour alimenter la LED on a choisi le transistor bipolaire NPN BC107 avec une résistance en série pour limiter le courant. Le BC107 a une tension VCEsat de 0.25 V pour un courant de 10 mA. En estimant une VCEsat de 0.30 V pour un courant de 20 mA :

RLED = (5V −VCEsat −Vf orward)/20mA = 145Ω ⇒ 150Ω

### 4.7 Mesures

Dans figure 3 on voit le fonctionnement du détecteur avec différent nombres d’impulsions. Dans la mesure au milieu le décodeur détecté correctement les 13 impulsions et la combinaison logique du signal du détecteur d’impulsion manquant et du compteur d’impulsion donne un signal de sortie (en vert). Dans le cas où le mauvais nombre d’impulsions (12 impulsions dans la mesure à gauche et 14 impulsions à droite) arrive à l’entrée il n’y a pas de signal à la sortie.


FIGURE 2 – ∎ Conversion courant-tension, ∎ Filtre passe-haut, ∎ Signal 10x amplifié, ∎ Schmitt trigger output

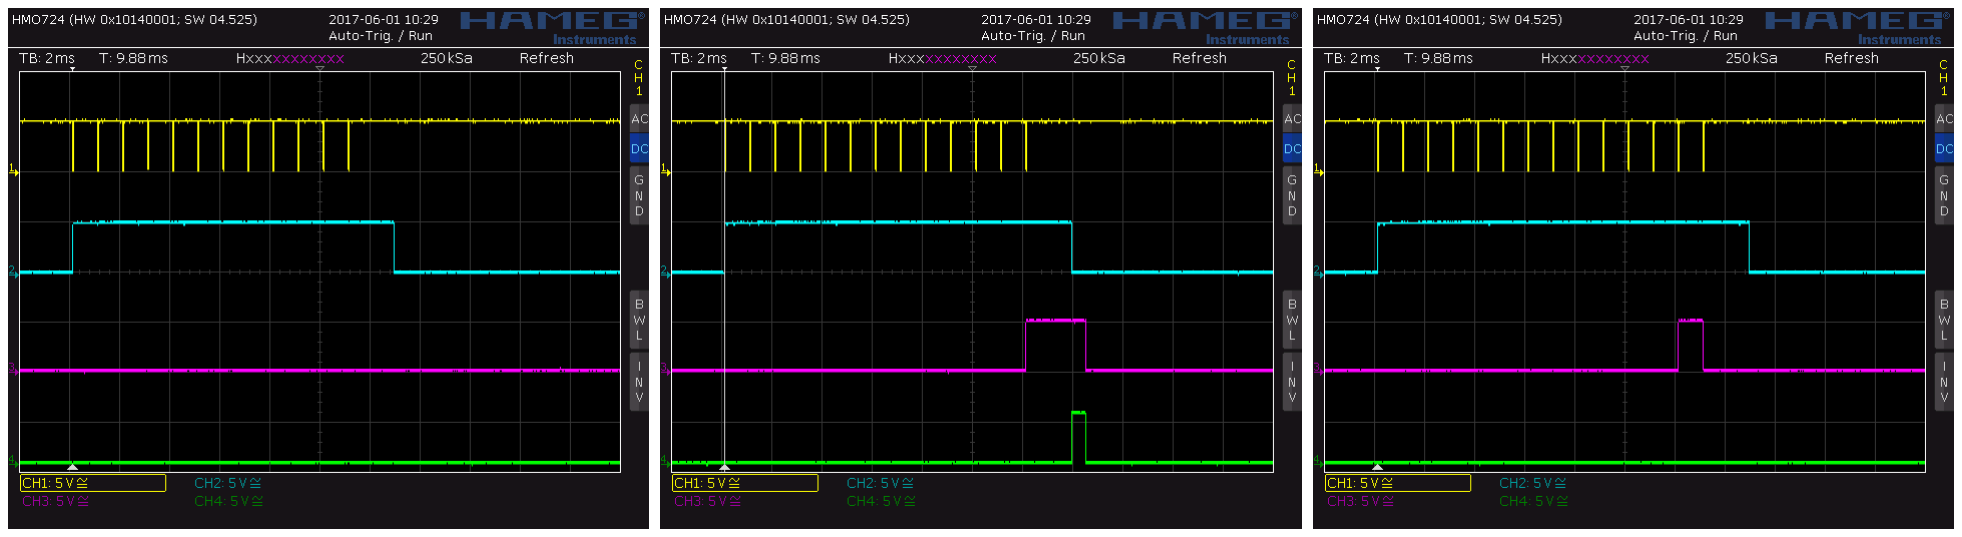
[picture p29: figure]

FIGURE 3 – ∎ Signal d’entrée, ∎ Détecteur d’impulsion manquant, ∎ Compteur d’impulsions, ∎ Sortie


FIGURE 4 – ∎ Signal d’entrée, ∎ Capacité sur bascule monostable, ∎ Sortie du détecteur de pause, ∎ Sortie

## Références

[1] OSRAM, LD271 - HGaAs Infrared Emitter, Version 1.0, 4 Avril 2007, http://www.osram-os.com/Graphics/XPic5/00082753_0.pdf/LD%20271,%20Lead%20(Pb)%20Free%20Product%20-%20RoHS% 20Compliant.pdf (http://www.osram-os.com/Graphics/XPic5/00082753_0.pdf/LD%20271,%20Lead%20(Pb)%20Free%20Product%20-%20RoHS%20Compliant.pdf)
[2] VISHAY, BP104 - Silicon PIN Photodiode, Revision : 08-Feb-17, http://www.vishay.com/docs/81500/81500.pdf
[3] TEXAS INSTRUMENTS, TLC555 LinCMOS™Timer, REVISED AUGUST 2016, SEPTEMBER 1983, http://www.ti.com/lit/ds/symlink/tlc555.pdf
[4] NXP, HEF4526B - Programmable 4-bit binary down counter - Product data sheet, Rev. 5, 22 November 2011,
http://www.nxp.com/documents/data_sheet/HEF4526B.pdf.
[5] NXP, HEF4001B - Quad 2-input NOR gate - Product data sheet, Rev. 10, 10 December 2015, https://assets.nexperia.com/documents/data-sheet/HEF4001B.pdf
[6] International Rectifier, IRLU8259PbF - HEXFET®Power MOSFET, PD - 97360, 16 December 2008, http://www.infineon.com/dgdl/irlr8259pbf.pdf?fileId=5546d462533600a40153566e1ebe26e9
[7] Texas Instruments, LMC6482 CMOS Dual Rail-to-Rail Input and Output Operational Amplifier, SNOS674E, April 2015,
http://www.ti.com/lit/ds/symlink/lmc6482.pdf

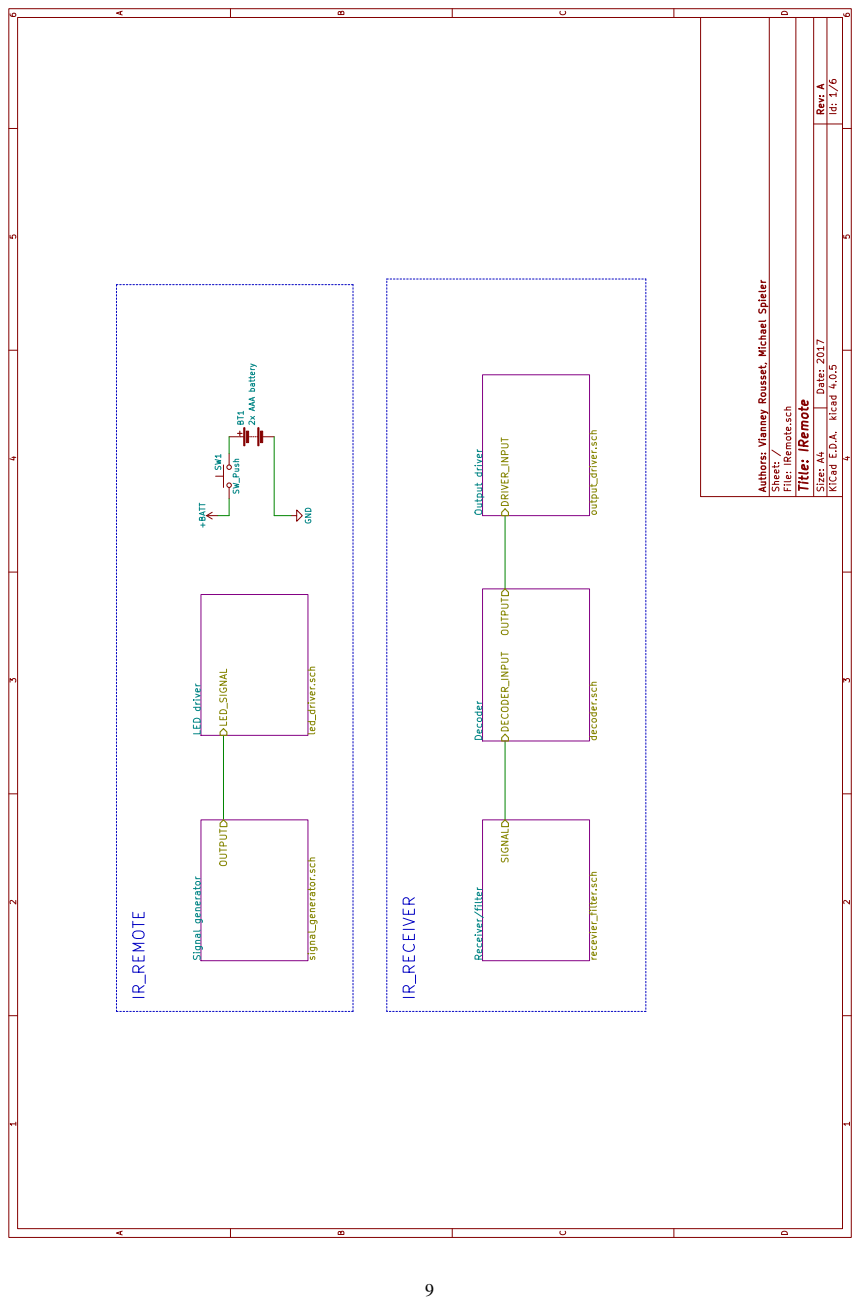
[picture p30: page 9]
GND; +BATT BT1; 2x AAA battery; IR_REMOTE; IR_RECEIVER; SW1 SW_Push Signal generator; signal_generator.sch; OUTPUT; LED driver; led_driver.sch; LED_SIGNAL; Receiver/filter; recevier_filter.sch; SIGNAL; Output driver; output_driver.sch

D Date: 2017 KiCad E.D.A. kicad 4.0.5 Rev: A Size: A4

Id: 1/6 Authors: Vianney Rousset, Michael Spieler Sheet: / File: IRemote.sch Title: IRemote

DRIVER_INPUT Decoder decoder.sch OUTPUT DECODER_INPUT

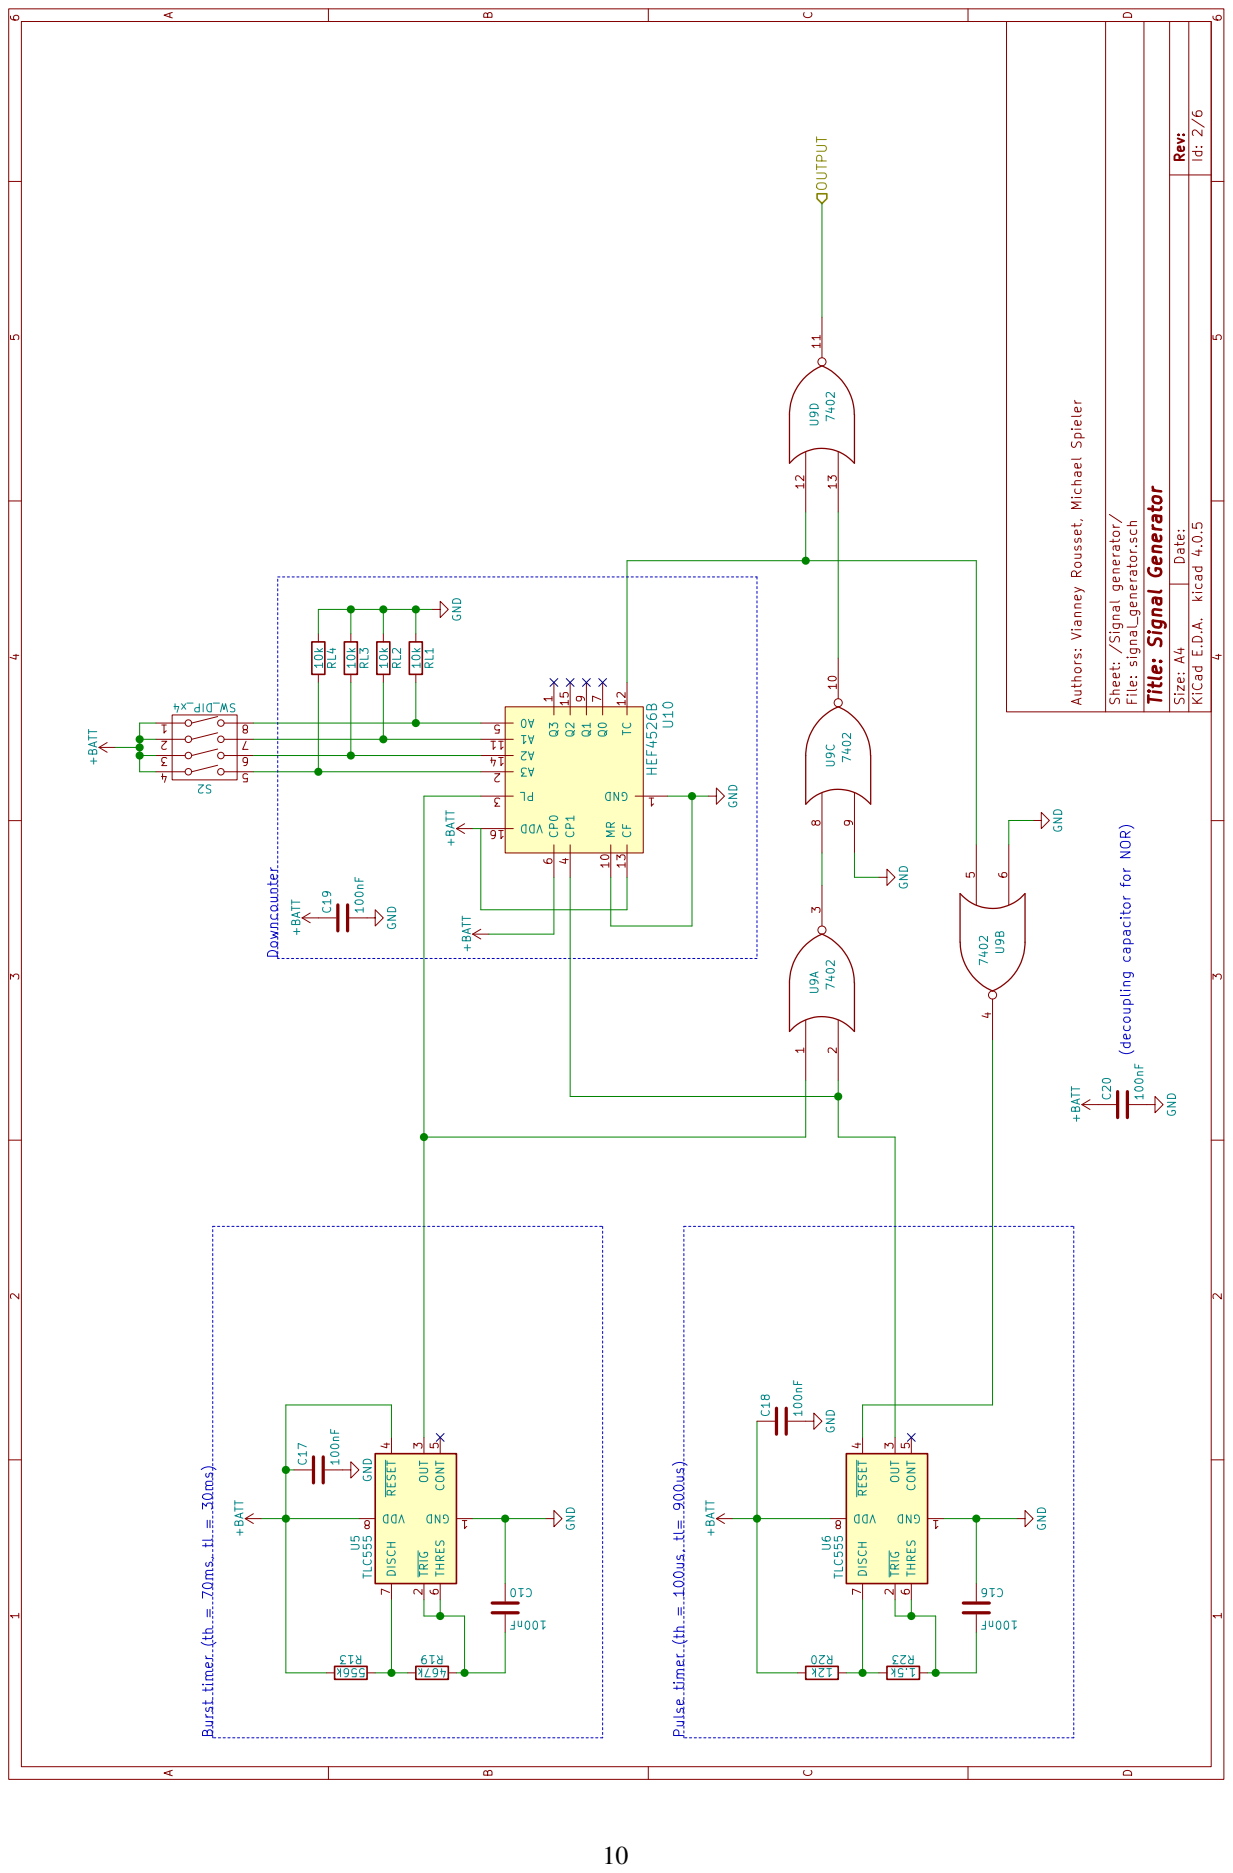
[picture p31: page 10]

D Date: KiCad E.D.A. kicad 4.0.5 Rev: Size: A4

Id: 2/6 Authors: Vianney Rousset, Michael Spieler

Title: Signal Generator GND

(decoupling capacitor for NOR)

Burst timer (th = 70ms, tl = 30ms) Downcounter GND

Pulse timer (th = 100us, tl= 900us) 1

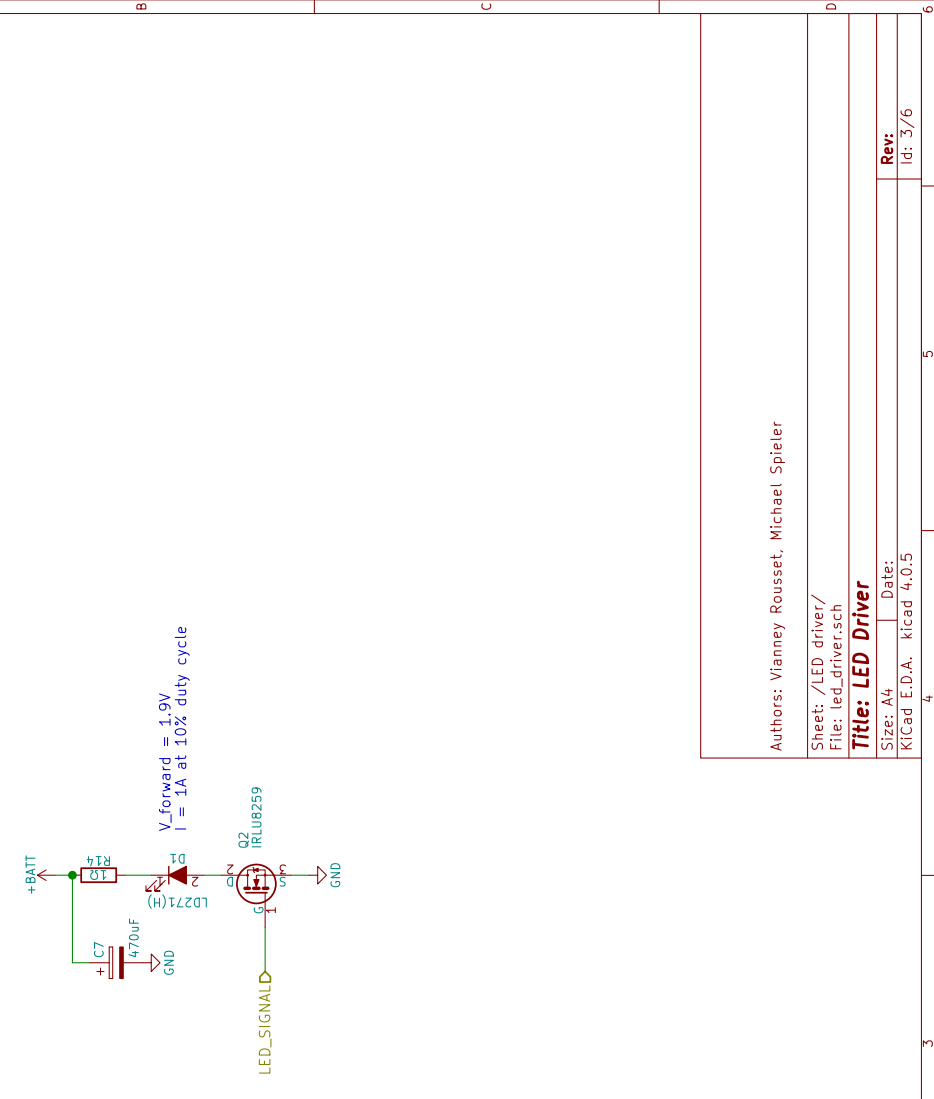
[picture p32: page 11]
LED_SIGNAL; IRLU8259 GND; +BATTR141 V_forward = 1.9V; 470uF GND

D Date: KiCad E.D.A. kicad 4.0.5 Rev: Size: A4

Id: 3/6 Authors: Vianney Rousset, Michael Spieler Sheet: /LED driver/ File: led_driver.sch

Title: LED Driver

I = 1A at 10% duty cycle C7

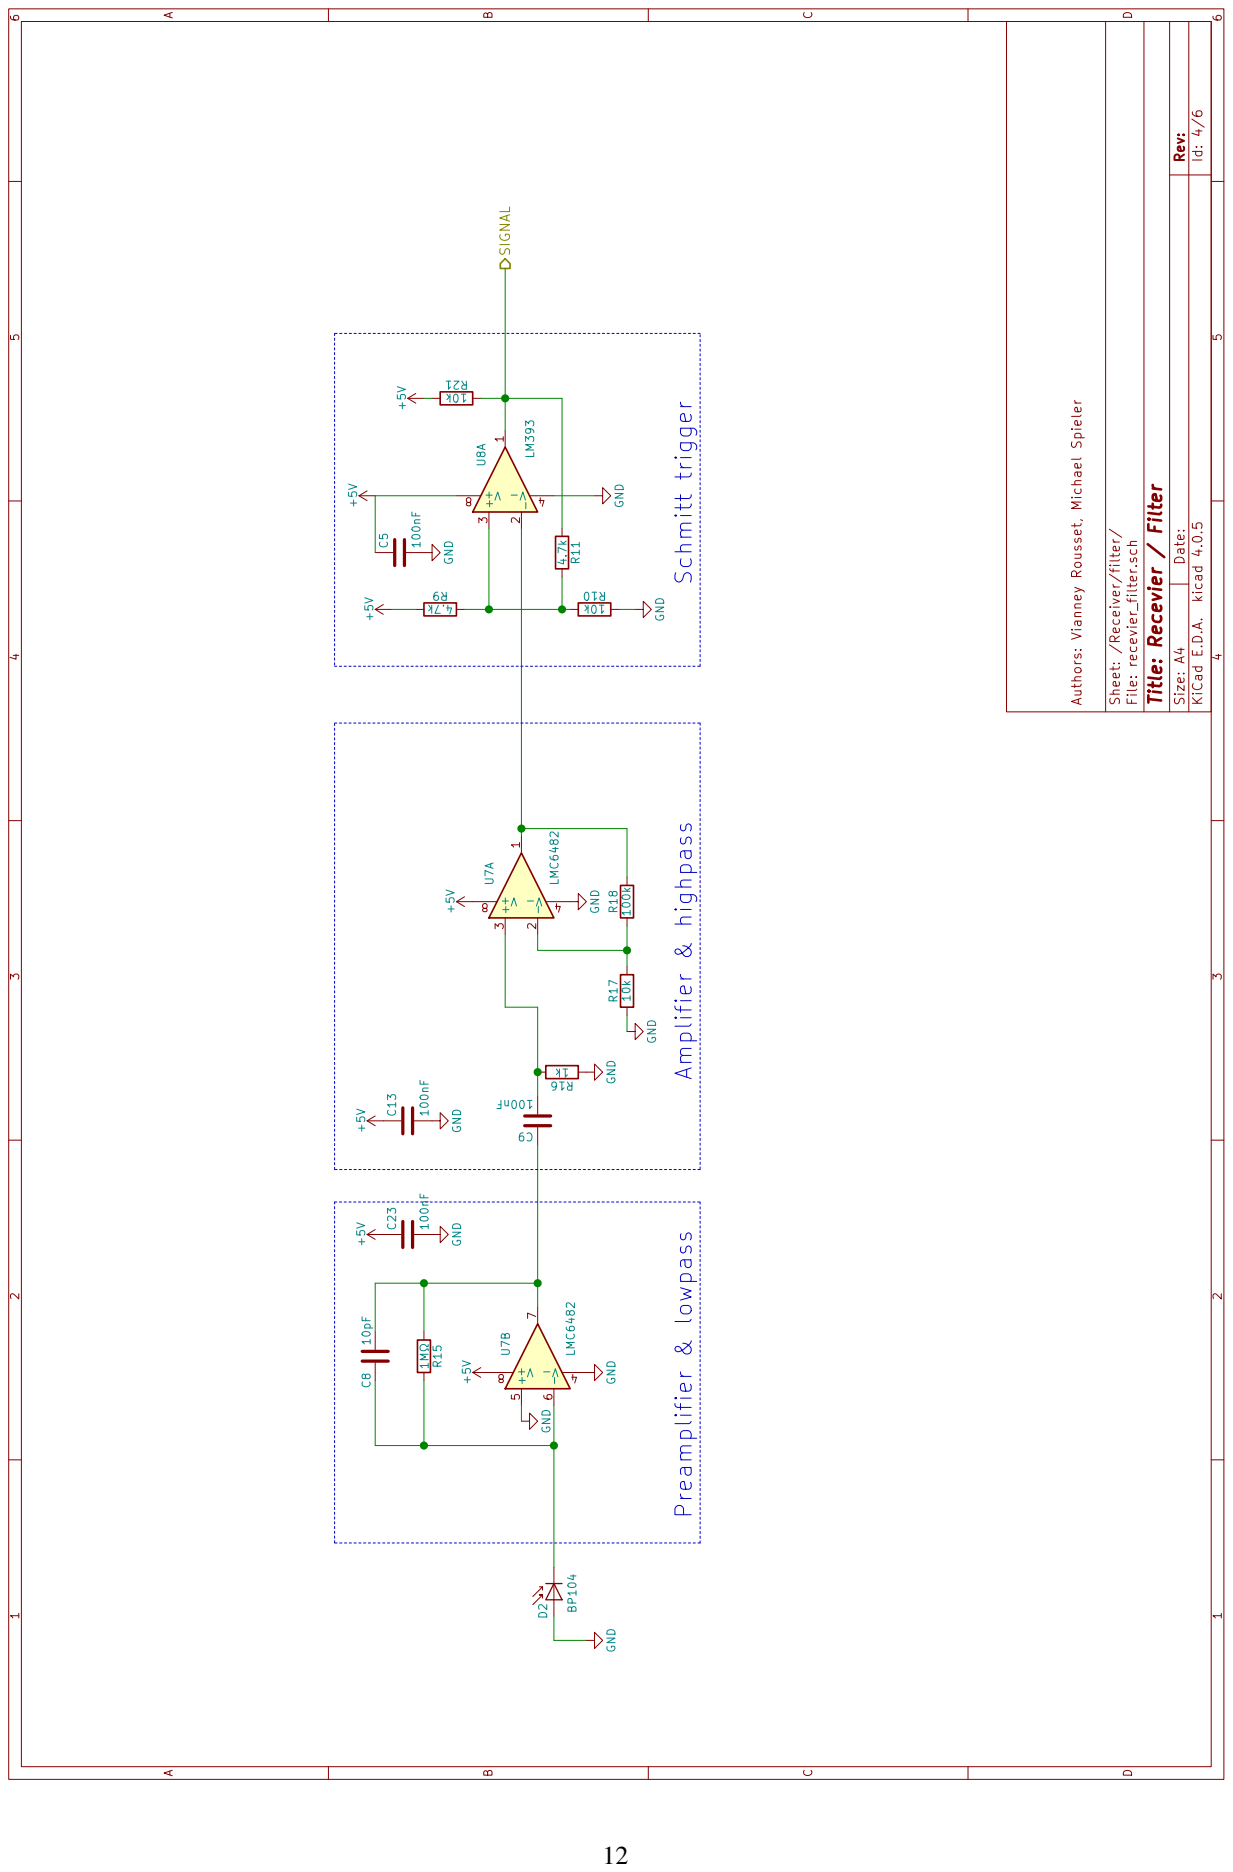
[picture p33: page 12]

D Date: KiCad E.D.A. kicad 4.0.5 Rev: Size: A4

Id: 4/6 Authors: Vianney Rousset, Michael Spieler Sheet: /Receiver/filter/ File: recevier_filter.sch

+5V GND Preamplifier & lowpass Amplifier & highpass

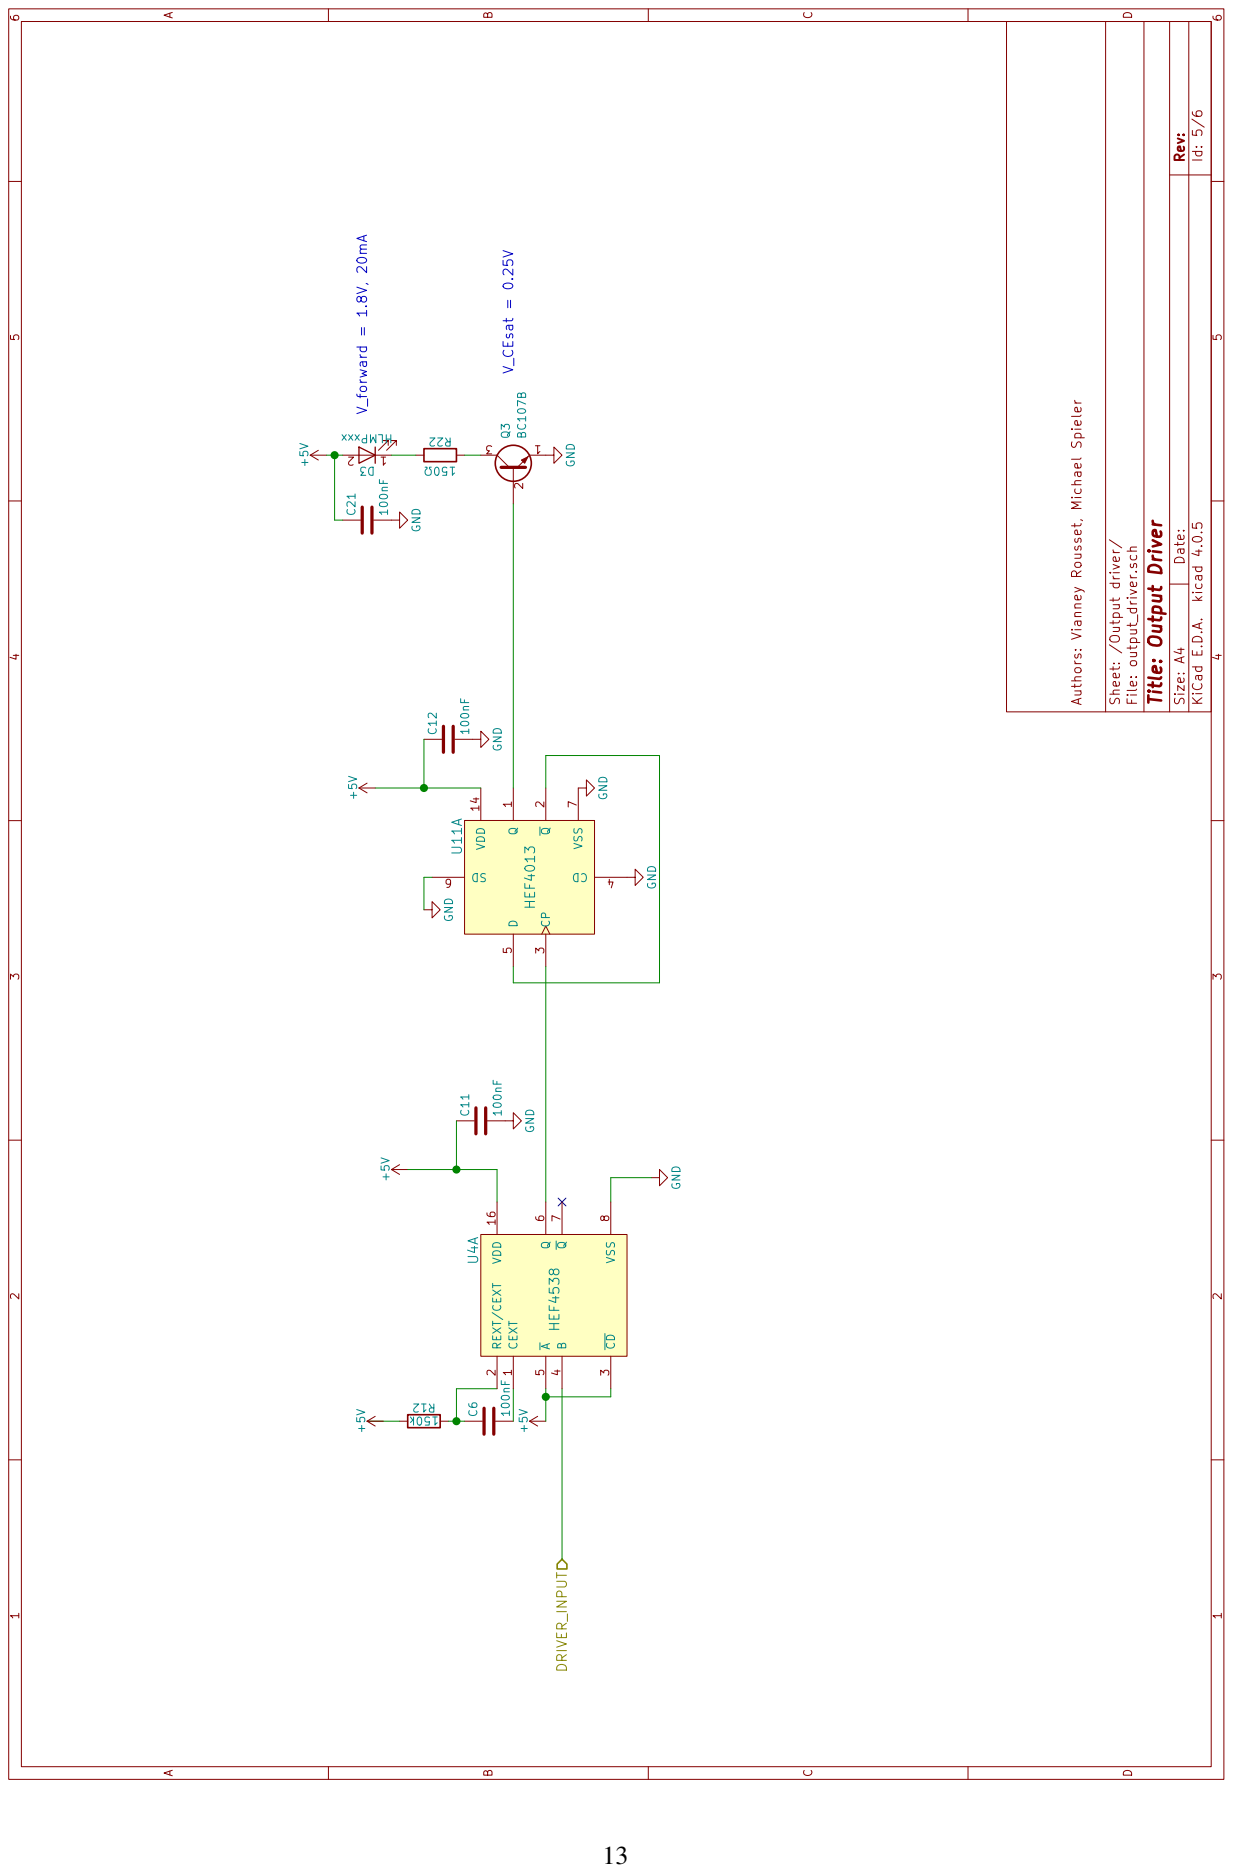
[picture p34: page 13]
File: output_driver.sch; DRIVER_INPUT; V_forward = 1.8V, 20mA; +5V GND; VSS 7 VDD 14 Q 1 Q; 100nF GND; 100nF GND GND; 7 U4A HEF4538 GND GND

D Date: KiCad E.D.A. kicad 4.0.5 Rev: Size: A4

Id: 5/6 Authors: Vianney Rousset, Michael Spieler

Title: Output Driver

Sheet: /Output driver/

VSS 8 VDD 16 CEXT 1 REXT/CEXT 2 CD 3 B

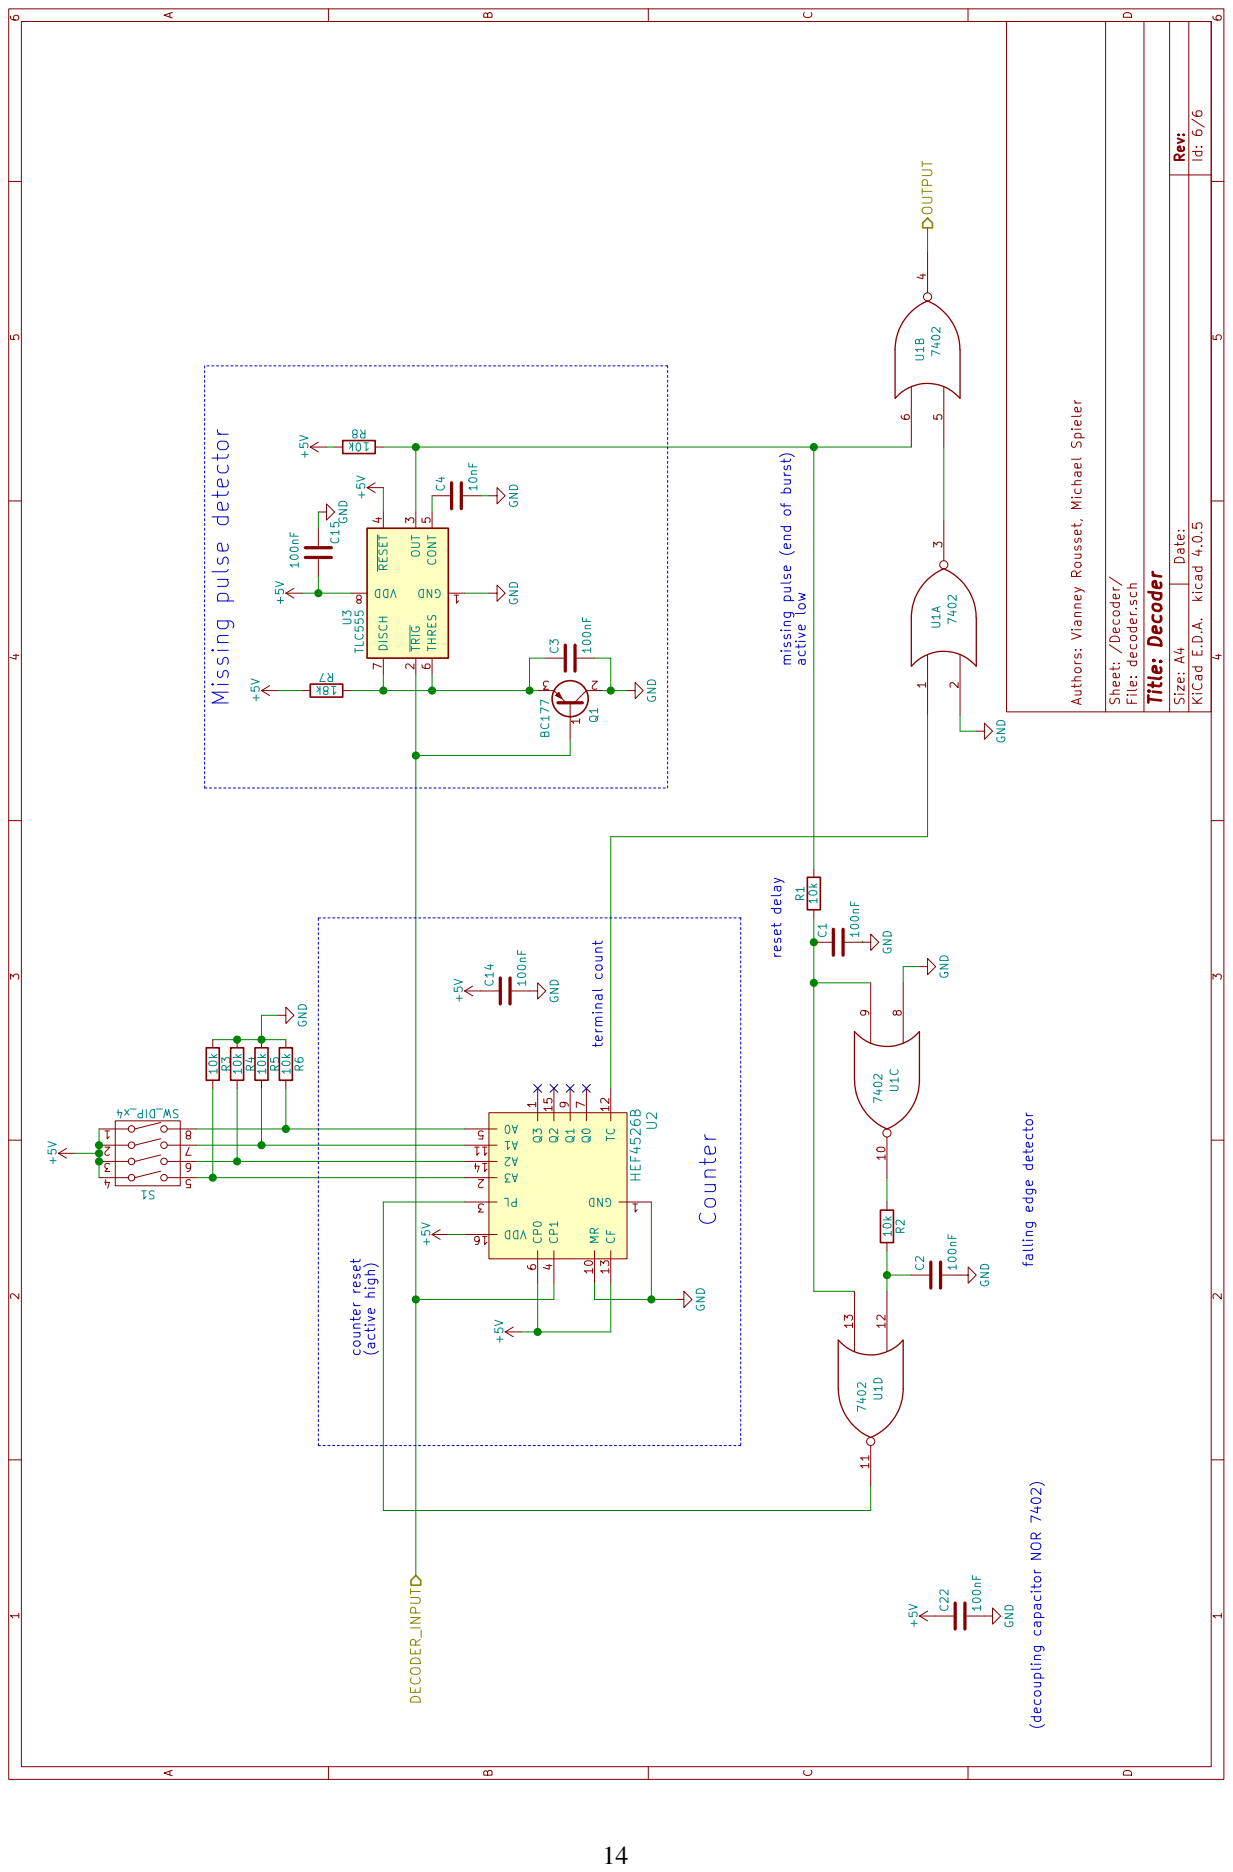
[picture p35: page 14]

D Date: KiCad E.D.A. kicad 4.0.5 Rev: Size: A4

Id: 6/6 Authors: Vianney Rousset, Michael Spieler Sheet: /Decoder/ File: decoder.sch Title: DecoderGND

missing pulse (end of burst) active low

counter reset (active high)
