VianneyRousset/IRemote/rapport/fig/output_led.pdf

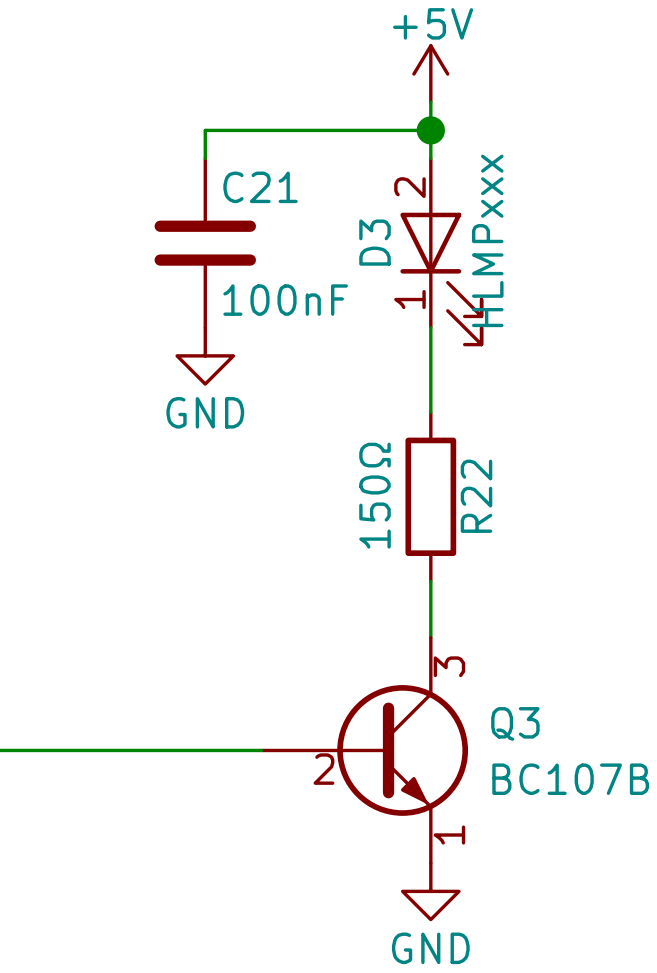
[picture p36: page 1]
HLMPxxx; GND ¹⁵⁰; R²² 1; GND
