VianneyRousset/IRemote/rapport/fig/amplifier.pdf

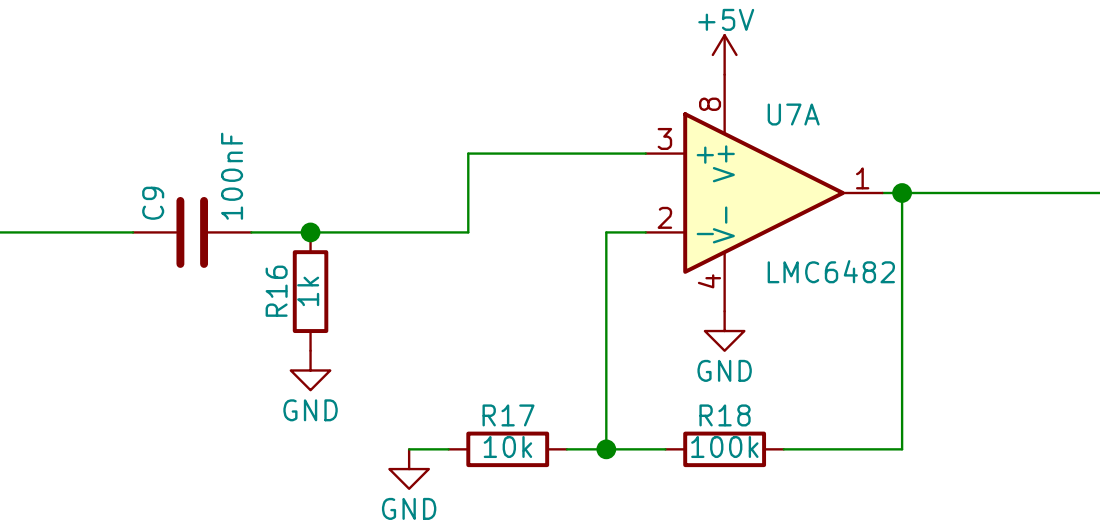
[picture p37: page 1]
GND; LMC6482
