VianneyRousset/IRemote/rapport/fig/commutator.pdf

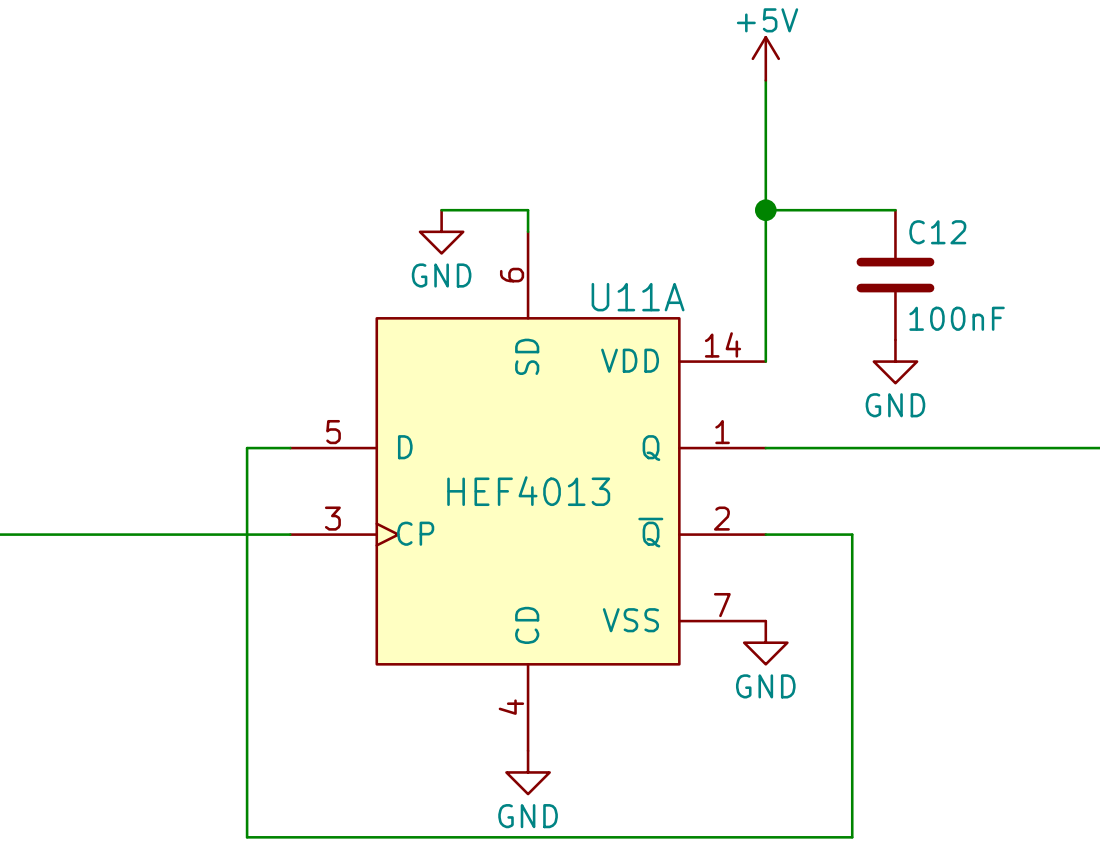
[picture p38: page 1]
VSS; VDD; HEF4013; GND
