VianneyRousset/IRemote/rapport/fig/current_to_voltage_converter.pdf

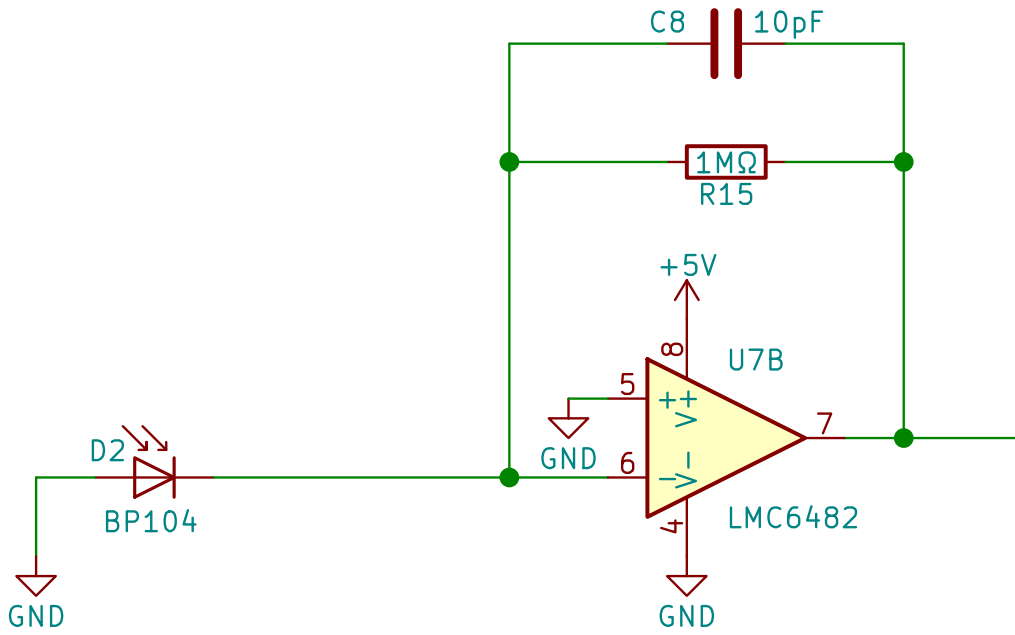
[picture p39: page 1]
GND; LMC6482
