VianneyRousset/IRemote/rapport/fig/decoder_counter.pdf

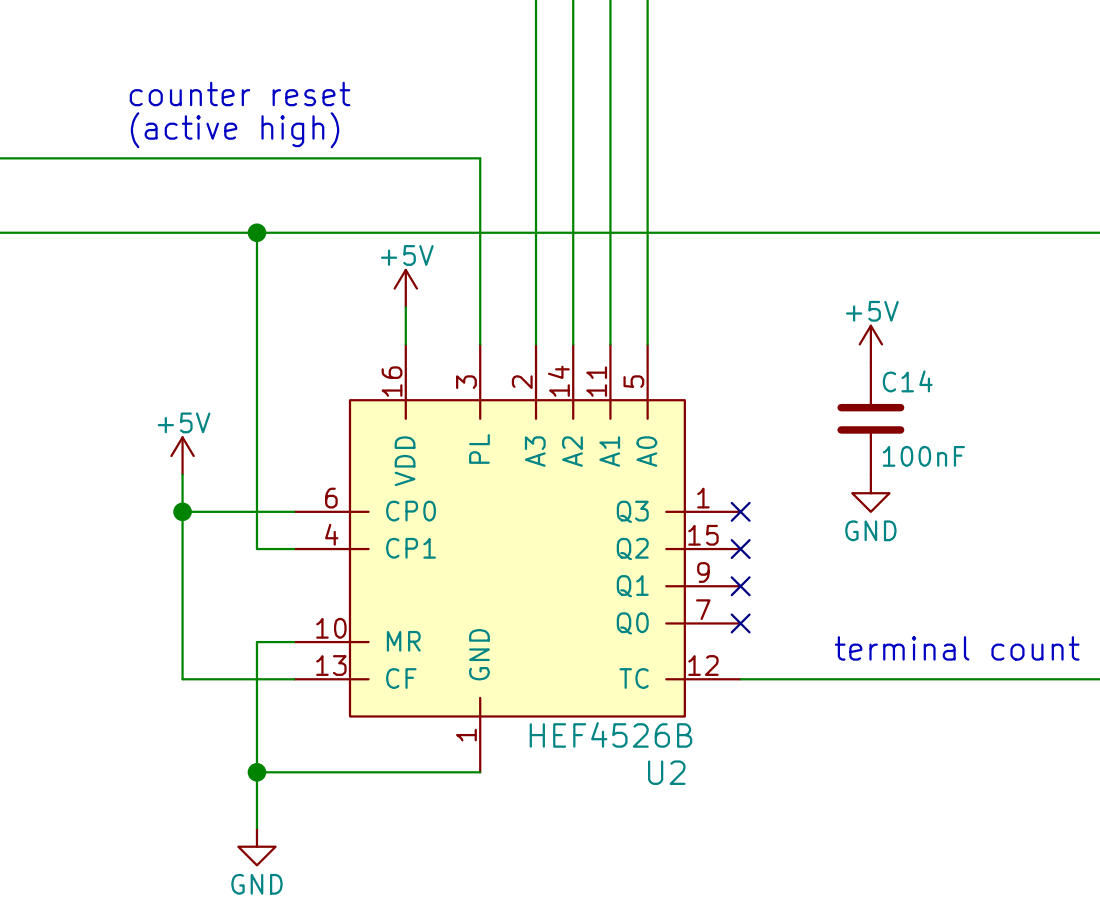
[picture p40: page 1]
GND 1; VDD 16; HEF4526B; GND; counter reset (active high); terminal count
