VianneyRousset/IRemote/rapport/fig/decoder_reset_delay.pdf

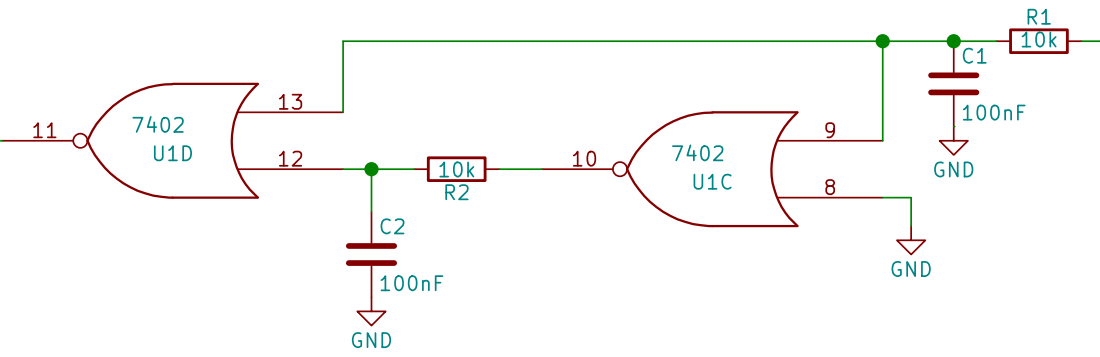
[picture p41: page 1]
GND
