VianneyRousset/IRemote/rapport/fig/interrupt_detect.pdf

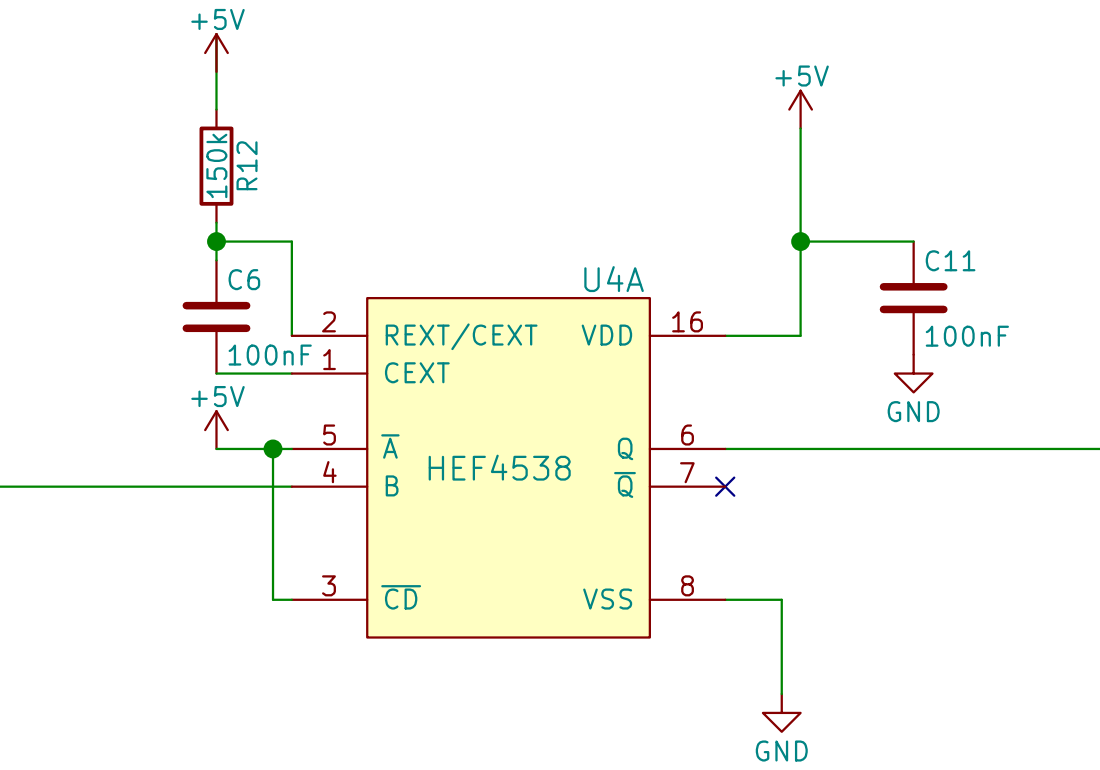
[picture p42: page 1]
GND; VSS; VDD; CEXT; REXT/CEXT 2; HEF4538
