VianneyRousset/IRemote/rapport/fig/ir_led.pdf

# +BATTR¹⁴

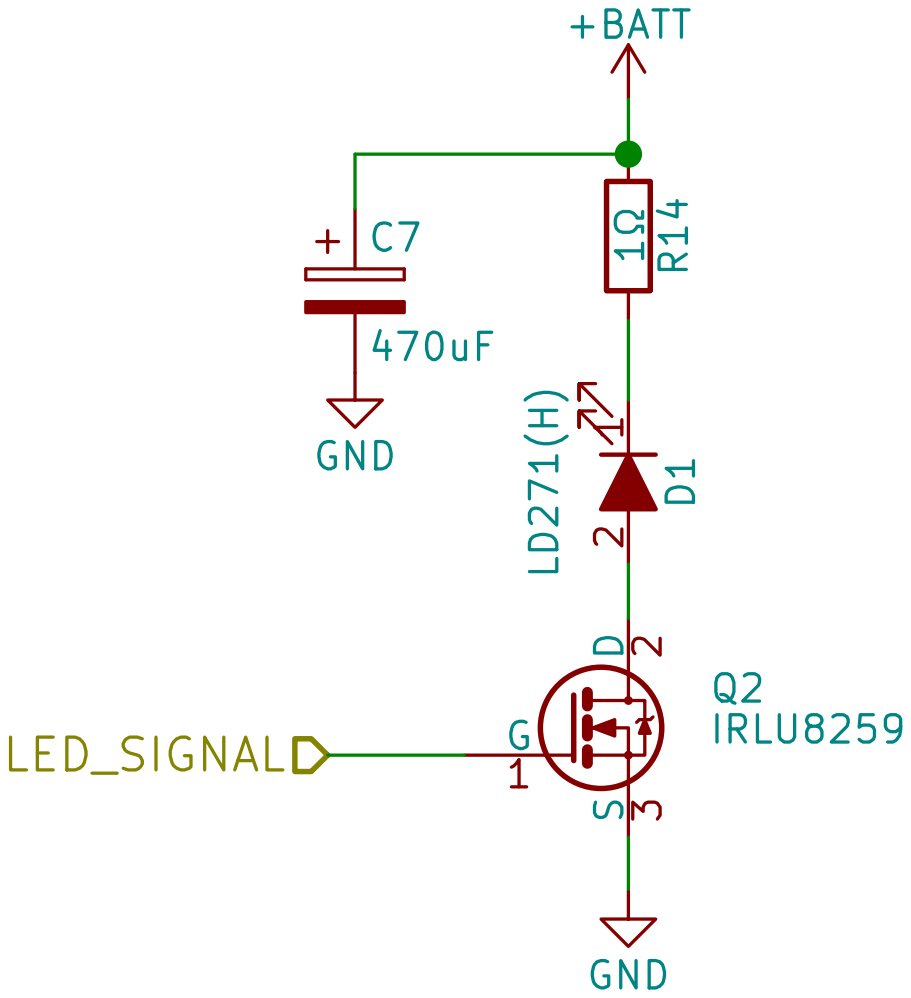
[picture p43: page 1]
LED_SIGNAL; Q2 IRLU8259; GND
