VianneyRousset/IRemote/schema/IRemote.pdf

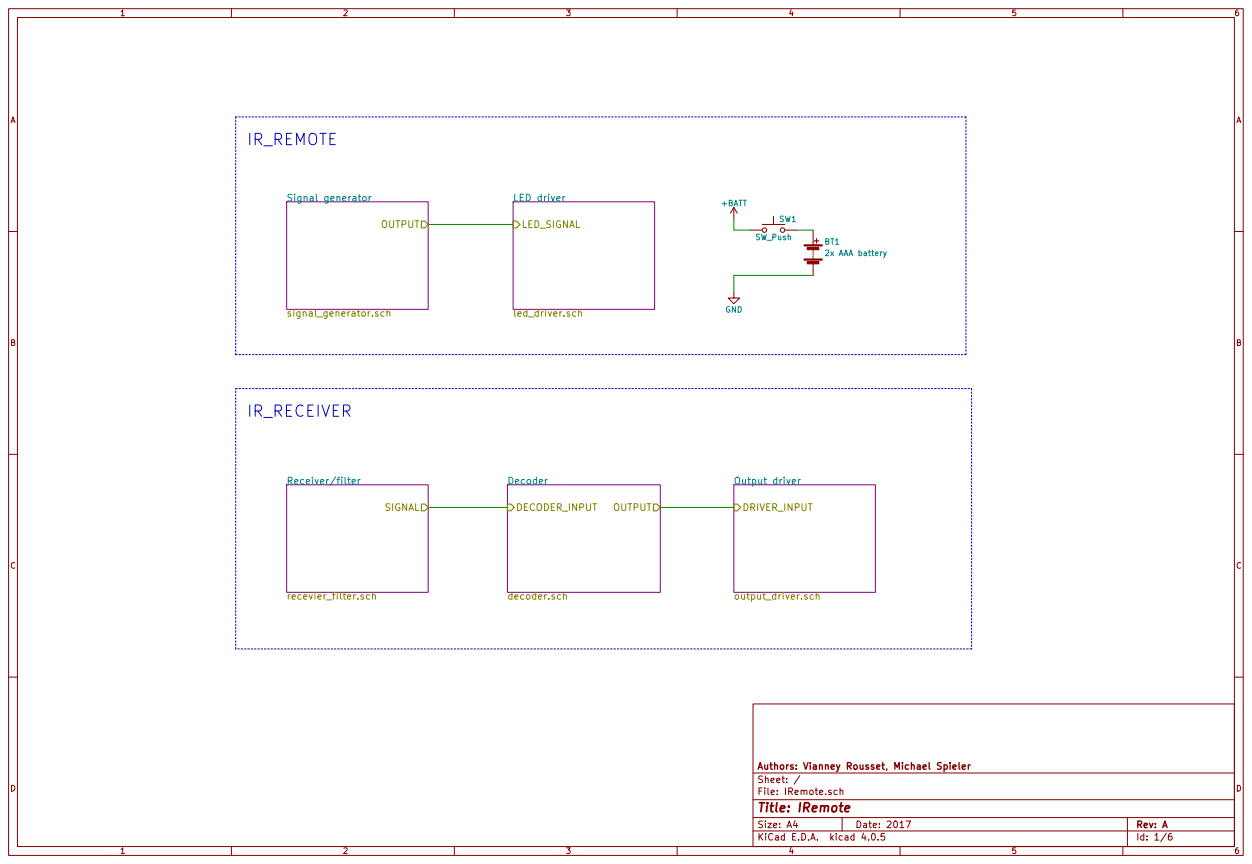
[picture p44: page 1]

File: IRemote.sch Sheet: / Authors: Vianney Rousset, Michael Spieler

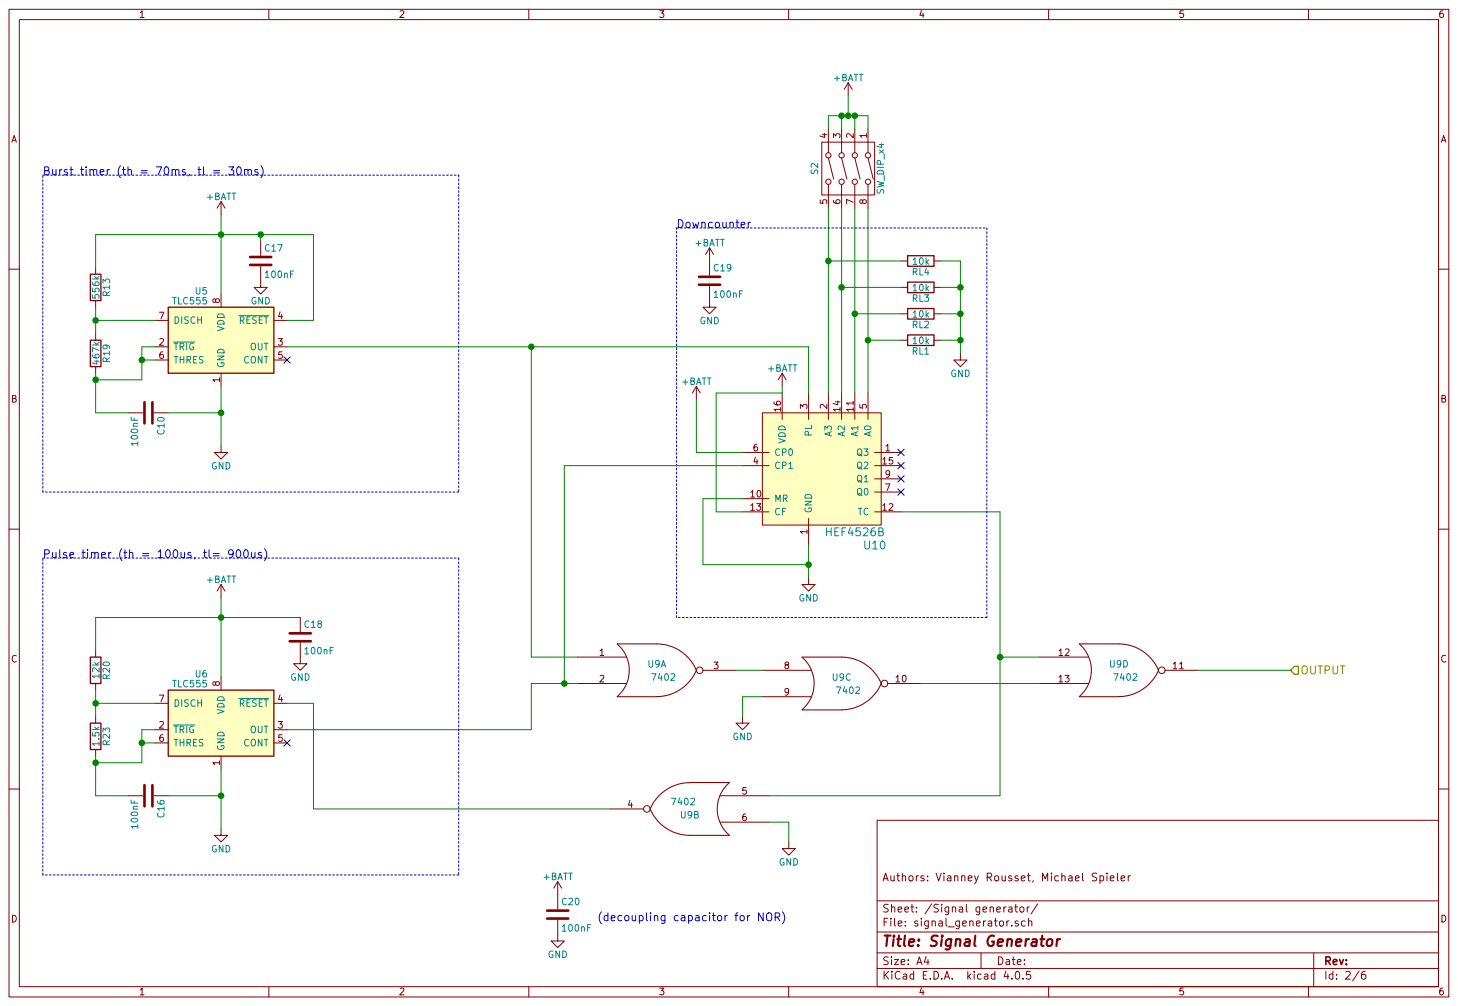
[picture p45: page 2]

+BATT | C19

1 TRIG 2 OUT 3 RESET 4 CONT 5 THRES 6 DISCH 7 VDD

5 CP0 6 Q0 7 Q1 9 MR 10 A1 11 TC 12 CF 13 A2 14 Q2 15 VDD 16 U10 HEF4526B GND

+BATT

Authors: Vianney Rousset, Michael Spieler GND

(decoupling capacitor for NOR)

Sheet: /Signal generator/
File: signal_generator.sch
Id: 2/6 Title: Signal Generator

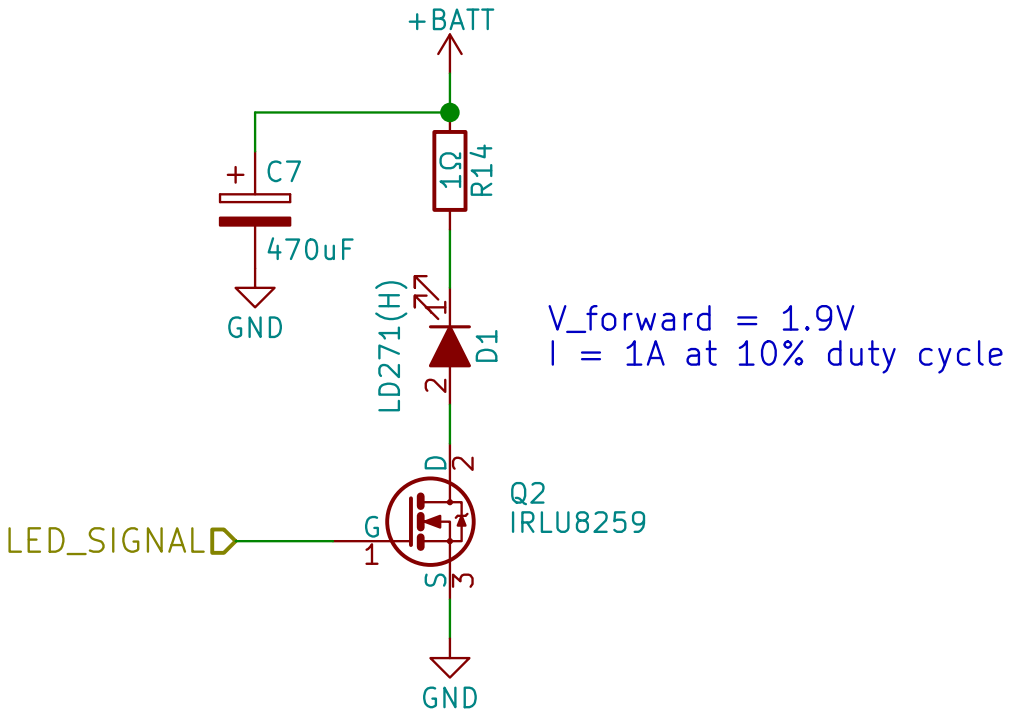
[picture p46: page 3]

File: led_driver.sch Sheet: /LED driver/ Authors: Vianney Rousset, Michael Spieler

Id: 3/6 Title: LED Driver

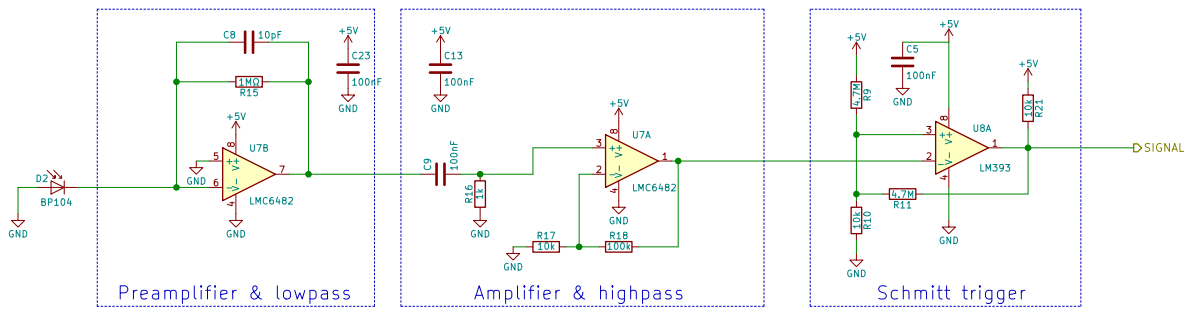
[picture p47: page 4]

File: recevier_filter.sch Sheet: /Receiver/filter/ Authors: Vianney Rousset, Michael Spieler

Id: 4/6 Title: Recevier / Filter

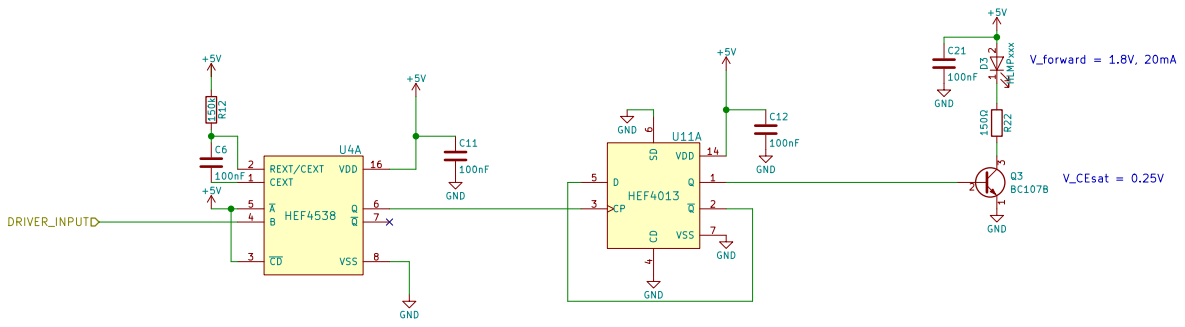
[picture p48: page 5]

Authors: Vianney Rousset, Michael Spieler

Sheet: /Output driver/
File: output_driver.sch
Id: 5/6 Title: Output Driver

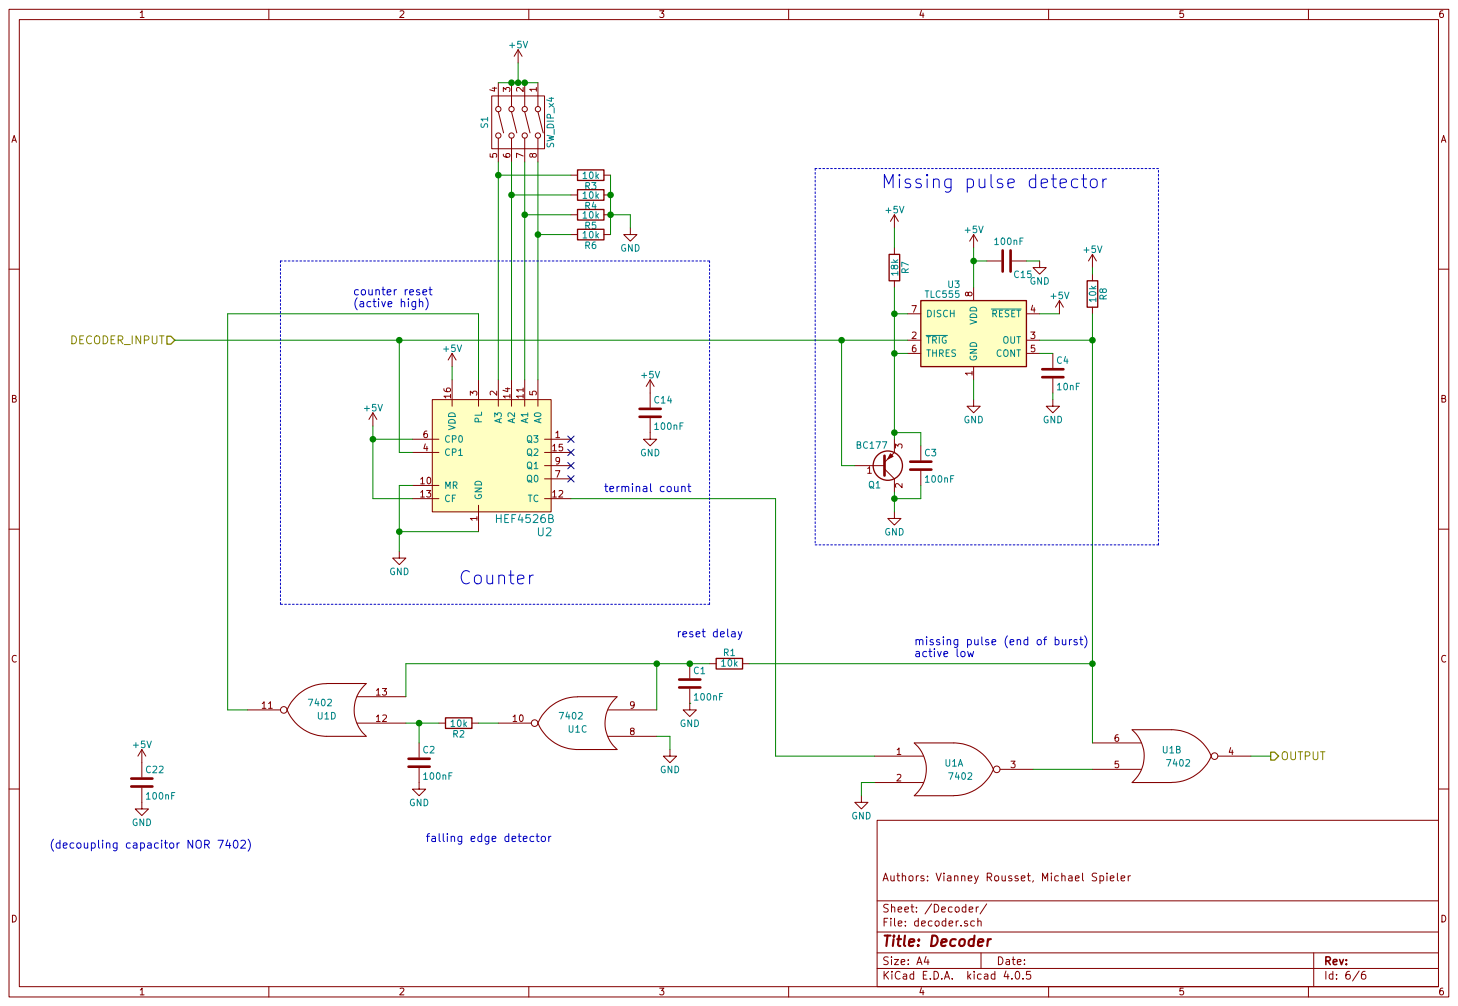
[picture p49: page 6]

counter reset (active high)

1 TRIG 2 OUT 3 RESET 4 CONT 5 THRES 6 DISCH 7 VDD

Id: 6/6 Title: Decoder File: decoder.sch Sheet: /Decoder/ Authors: Vianney Rousset, Michael Spieler GND

5 CP0 6 Q0 7 Q1 9 MR 10 A1 11 TC 12 CF 13 A2 14 Q2 15 VDD 16 U2 HEF4526B

missing pulse (end of burst) active low
