VianneyRousset/IRemote/rapport/fig/communication.pdf

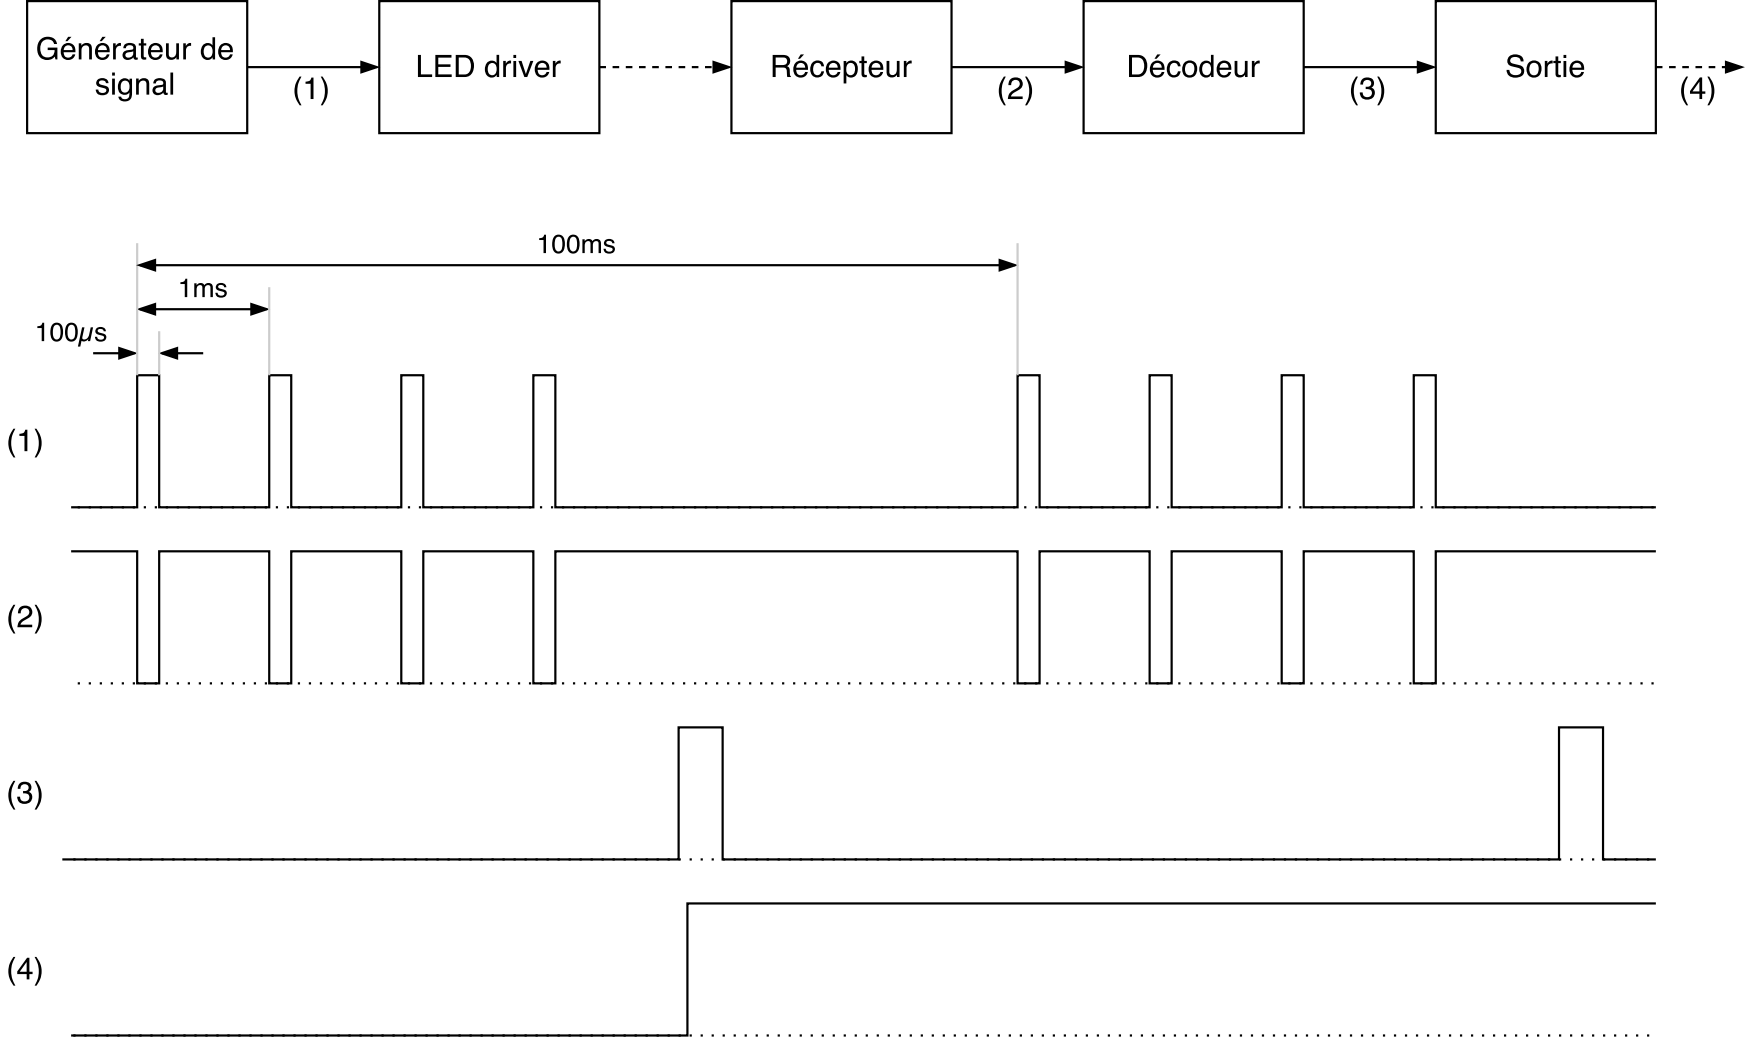
[picture p50: page 1]
