VianneyRousset/IRemote/schema/IRemote.sch

## KiCad design schema/IRemote.sch (2017-06-12)

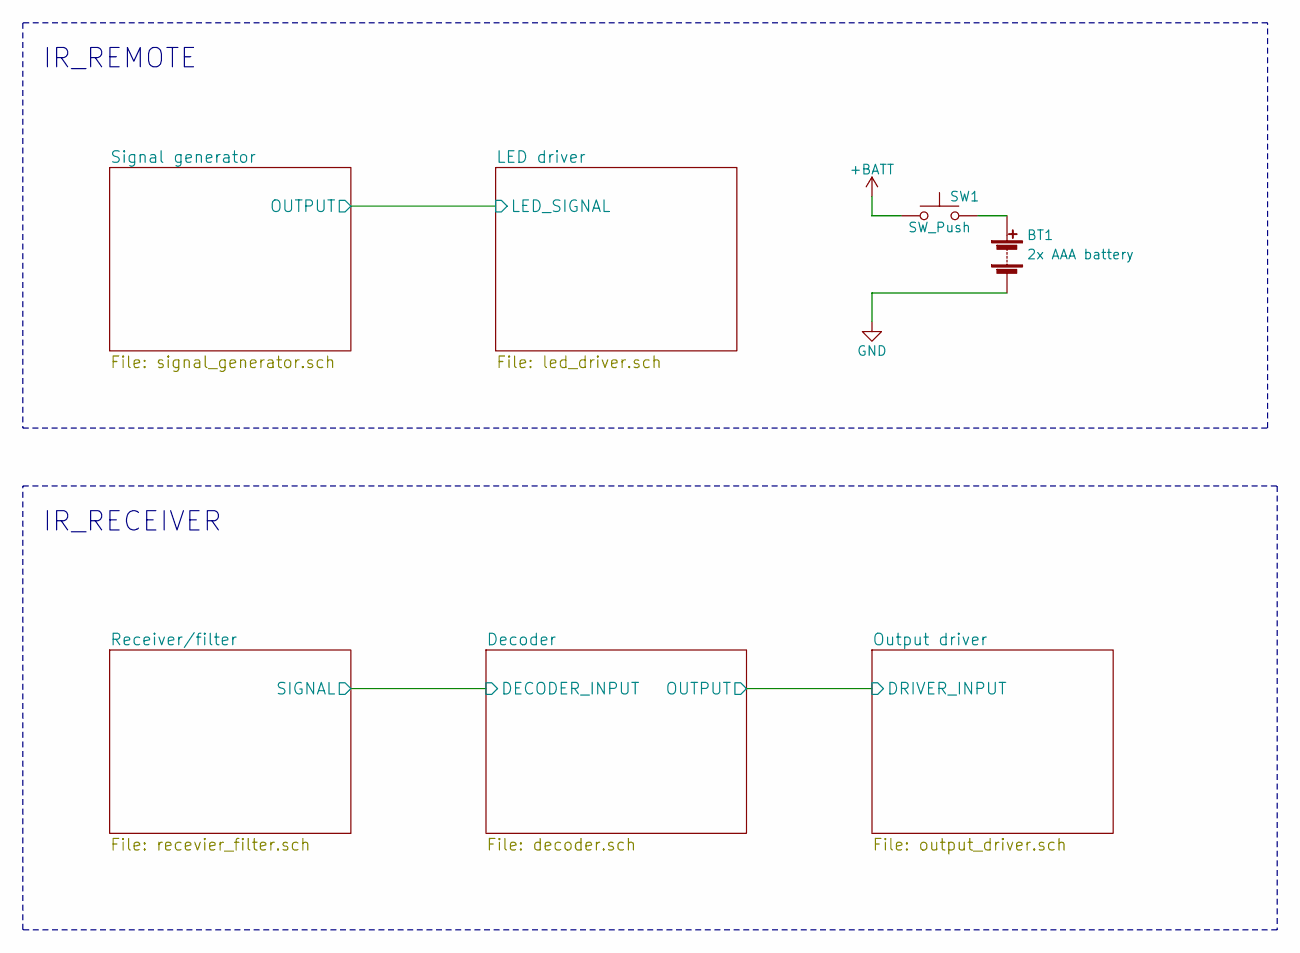
[picture p51: schematic IRemote.sch]

Parts:
BT1: 2x AAA battery
SW1: SW_Push

Connections:
+BATT: SW1.1
GND: BT1.2 (-)
unnamed: BT1.1 (+), SW1.2

Notes on the sheet:
IR_RECEIVER
IR_REMOTE
