VianneyRousset/IRemote/schema/decoder.sch

## KiCad design schema/decoder.sch (2017-06-12)

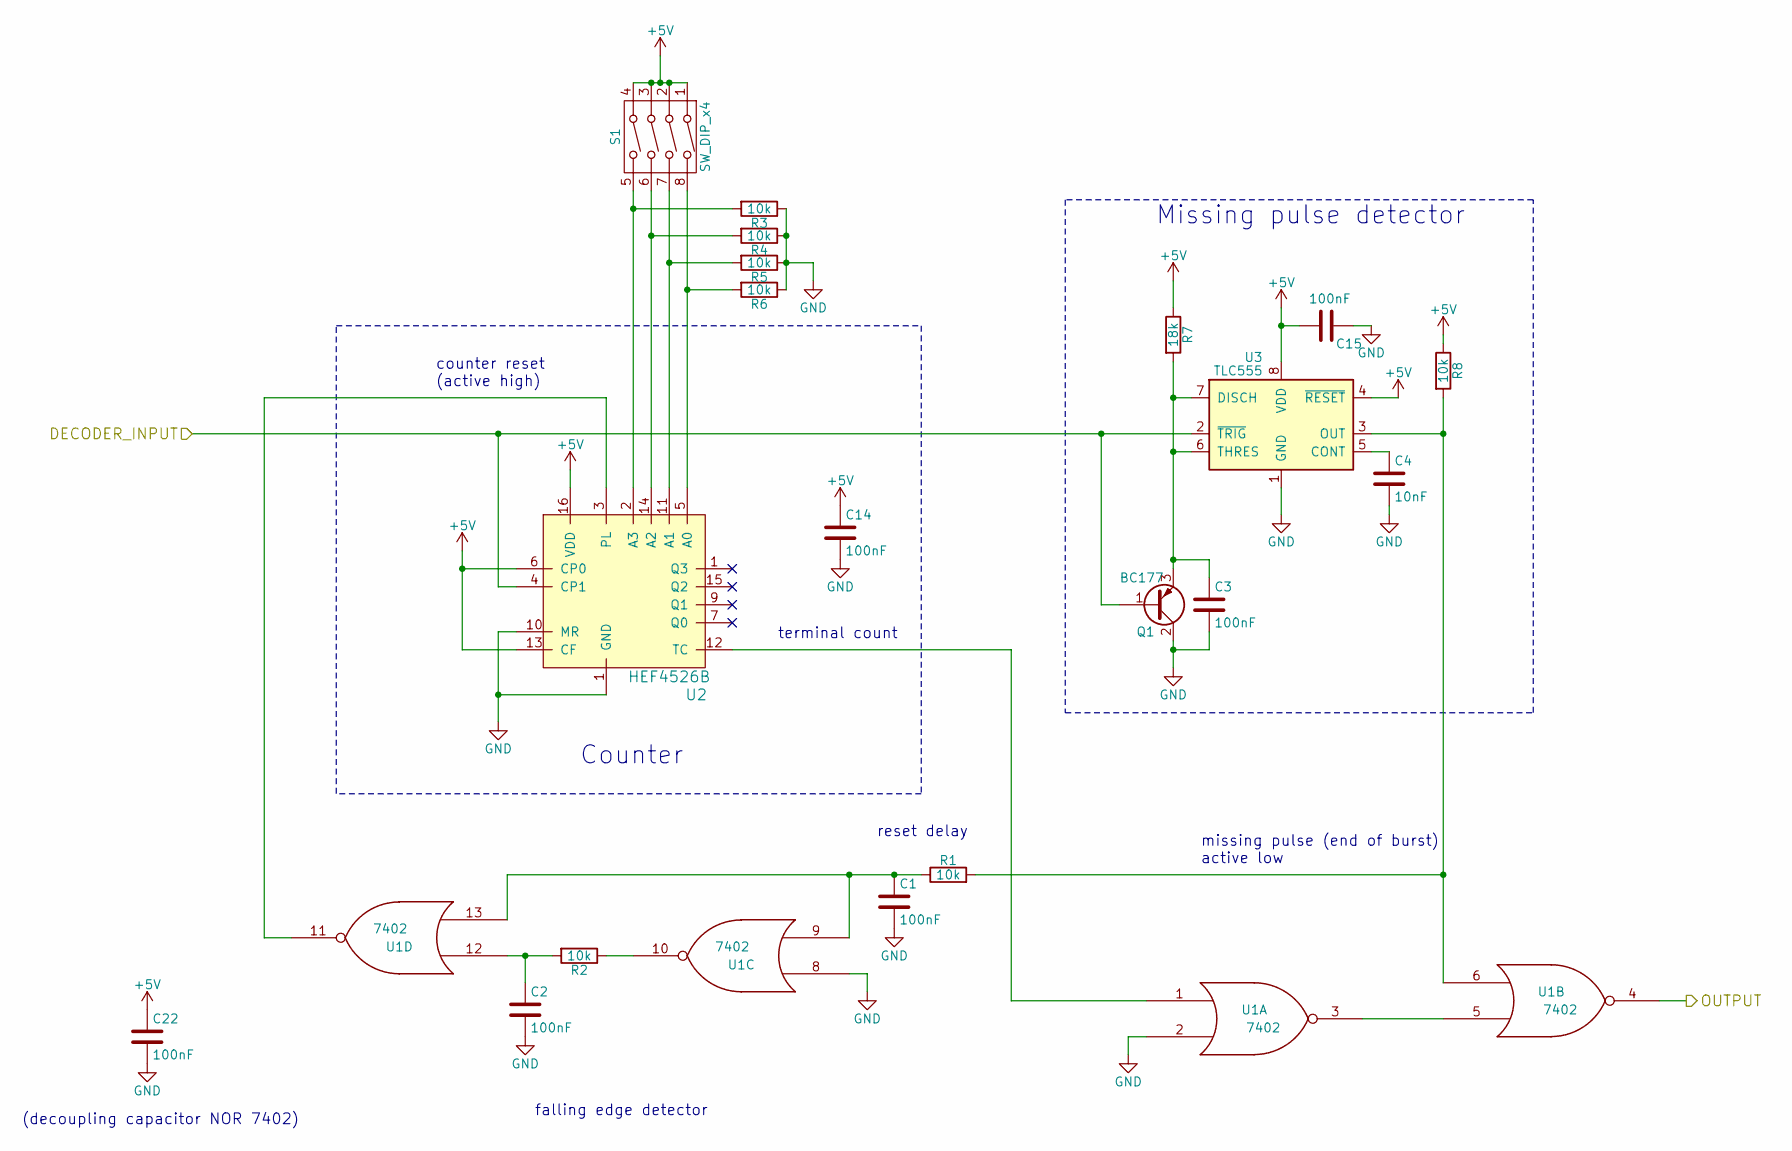
[picture p52: schematic decoder.sch]

Parts:
C1, C2, C3, C14, C15, C22: 100nF
C4: 10nF
Q1: BC177
R1, R2, R3, R4, R5, R6, R8: 10k
R7: 18k
S1: SW_DIP_x4
U1: 7402
U2: HEF4526B
U3: TLC555

Connections:
+5V: C14.1, C15.2, C22.1, R7.1, R8.1, S1.1, S1.2, S1.3, S1.4, U2.6 (CP0), U2.13 (CF), U2.16 (VDD), U3.4 (~RESET), U3.8 (VDD)
DECODER_INPUT: Q1.1 (B), U2.4 (CP1), U3.2 (~TRIG)
GND: C1.2, C2.2, C3.2, C4.2, C14.2, C15.1, C22.2, Q1.2 (C), R3.1, R4.1, R5.1, R6.1, U1.2, U1.8, U2.1 (GND), U2.10 (MR), U3.1 (GND)
unnamed: C1.1, R1.1, U1.9, U1.13
unnamed: C2.1, R2.2, U1.12
unnamed: C3.1, Q1.3 (E), R7.2, U3.6 (THRES), U3.7 (DISCH)
unnamed: C4.1, U3.5 (CONT)
unnamed: R1.2, R8.2, U1.6, U3.3 (OUT)
unnamed: R2.1, U1.10
unnamed: R3.2, S1.5, U2.2 (A3)
unnamed: R4.2, S1.6, U2.14 (A2)
unnamed: R5.2, S1.7, U2.11 (A1)
unnamed: R6.2, S1.8, U2.5 (A0)
unnamed: U1.1, U2.12 (TC)
unnamed: U1.3, U1.5
unnamed: U1.11, U2.3 (PL)
OUTPUT: U1.4

Notes on the sheet:
Missing pulse detector
Counter
counter reset (active high)
missing pulse (end of burst) active low
terminal count
falling edge detector
reset delay
(decoupling capacitor NOR 7402)
