VianneyRousset/IRemote/schema/led_driver.sch

## KiCad design schema/led_driver.sch (2017-06-12)

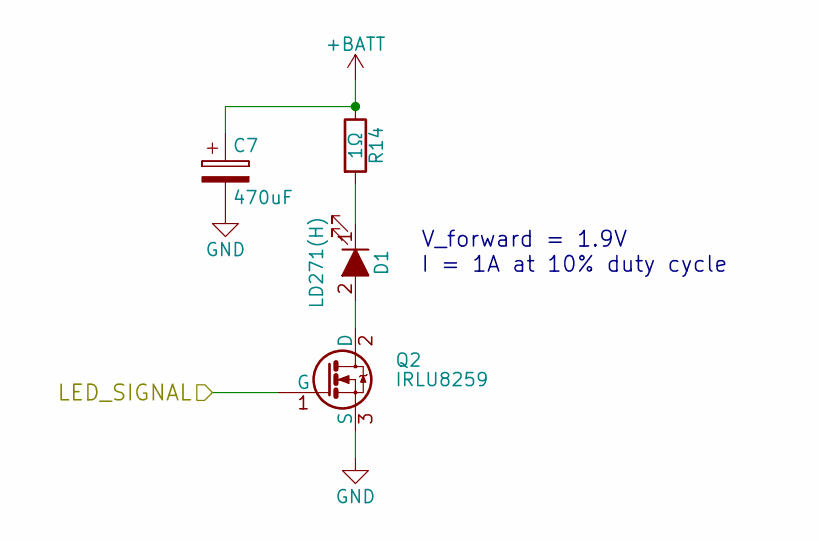
[picture p53: schematic led_driver.sch]

Parts:
C7: 470uF
D1: LD271(H)
Q2: IRLU8259; TO-220_Neutral123_Vertical
R14: 1Ω

Connections:
+BATT: C7.1, R14.1
GND: C7.2, Q2.3 (S)
LED_SIGNAL: Q2.1 (G)
unnamed: D1.1 (K), R14.2
unnamed: D1.2 (A), Q2.2 (D)

Notes on the sheet:
V_forward = 1.9V I = 1A at 10% duty cycle
