VianneyRousset/IRemote/schema/output_driver.sch

## KiCad design schema/output_driver.sch (2017-06-12)

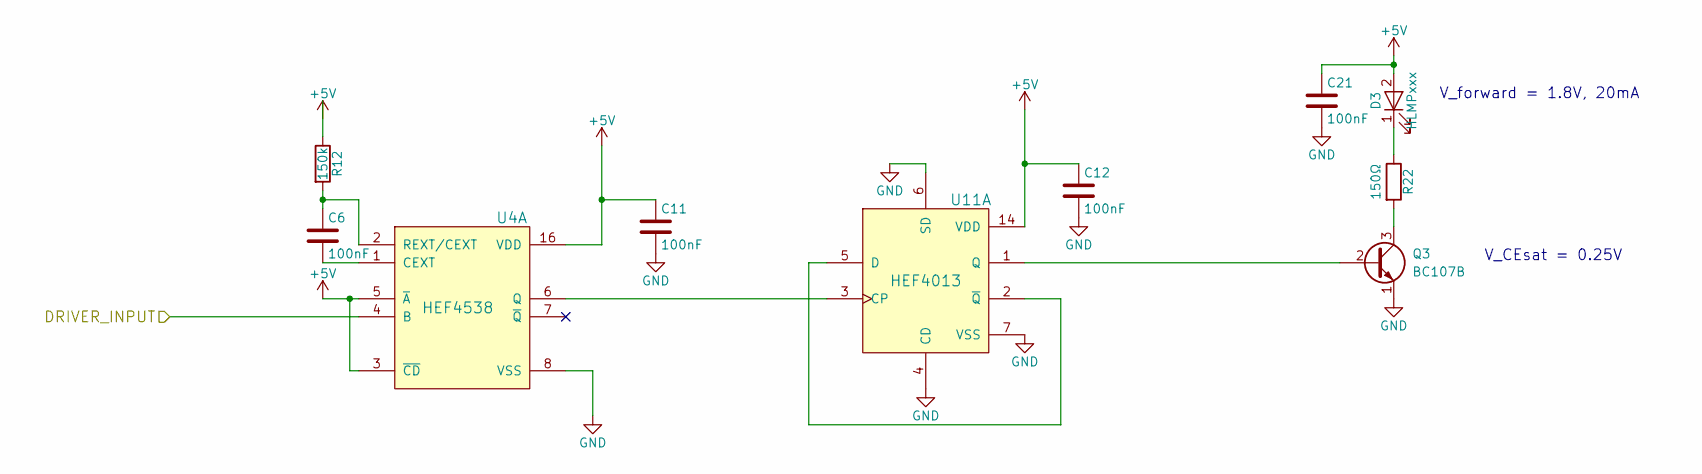
[picture p54: schematic output_driver.sch]

Parts:
C6, C11, C12, C21: 100nF
D3: HLMPxxx
Q3: BC107B
R12: 150k
R22: 150Ω
U4: HEF4538
U11: HEF4013

Connections:
+5V: C11.1, C12.1, C21.1, D3.2 (A), R12.1, U4.3 (~CD), U4.5 (~A), U4.16 (VDD), U11.14 (VDD)
DRIVER_INPUT: U4.4 (B)
GND: C11.2, C12.2, C21.2, Q3.1 (E), U4.8 (VSS), U11.4 (CD), U11.6 (SD), U11.7 (VSS)
unnamed: C6.1, R12.2, U4.2 (REXT/CEXT)
unnamed: C6.2, U4.1 (CEXT)
unnamed: D3.1 (K), R22.1
unnamed: Q3.2 (B), U11.1 (Q)
unnamed: Q3.3 (C), R22.2
unnamed: U11.2 (~Q), U11.5 (D)
unnamed: U4.6 (Q), U11.3 (CP)

Notes on the sheet:
V_forward = 1.8V, 20mA
V_CEsat = 0.25V
