VianneyRousset/IRemote/schema/recevier_filter.sch

## KiCad design schema/recevier_filter.sch (2017-06-13)

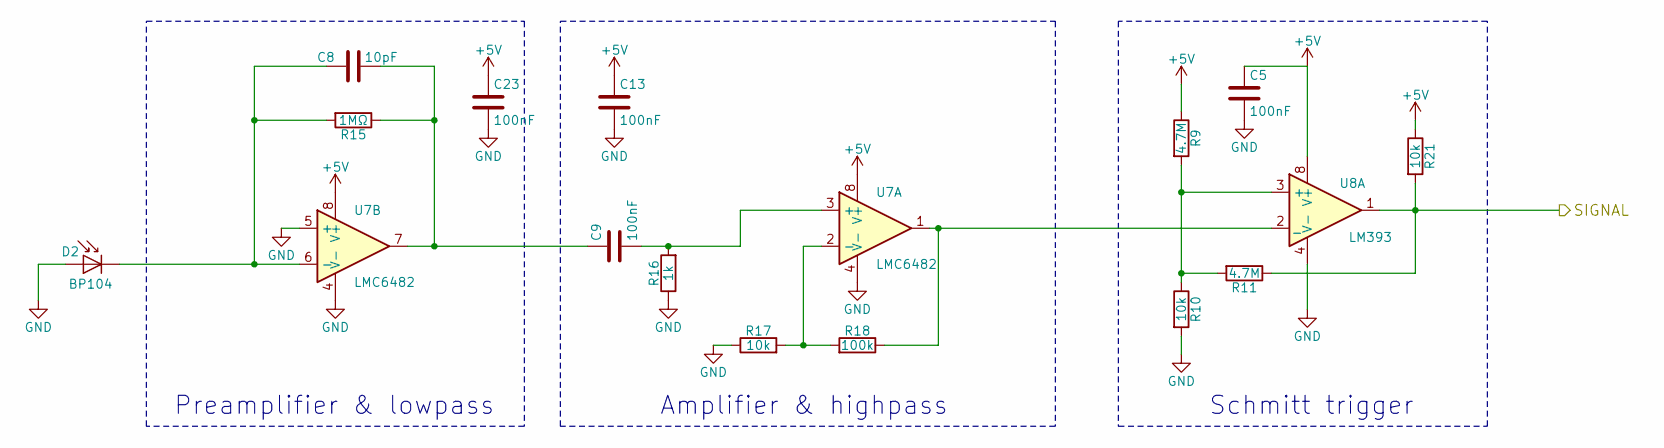
[picture p55: schematic recevier_filter.sch]

Parts:
C5, C9, C13, C23: 100nF
C8: 10pF
D2: BP104
R9, R11: 4.7M
R10, R17, R21: 10k
R15: 1MΩ
R16: 1k
R18: 100k
U7: LMC6482
U8: LM393

Connections:
+5V: C5.1, C13.1, C23.1, R9.1, R21.1, U7.8 (V+), U8.8 (V+)
GND: C5.2, C13.2, C23.2, D2.2 (A), R10.2, R16.1, R17.1, U7.4 (V-), U7.5 (+), U8.4 (V-)
unnamed: C8.1, D2.1 (K), R15.2, U7.6 (-)
unnamed: C8.2, C9.1, R15.1, U7.7
unnamed: C9.2, R16.2, U7.3 (+)
unnamed: R9.2, R10.1, R11.2, U8.3 (+)
unnamed: R17.2, R18.2, U7.2 (-)
unnamed: R18.1, U7.1, U8.2 (_)
SIGNAL: R11.1, R21.2, U8.1

Notes on the sheet:
Preamplifier & lowpass
Amplifier & highpass
Schmitt trigger
