VianneyRousset/IRemote/schema/signal_generator.sch

## KiCad design schema/signal_generator.sch (2017-06-12)

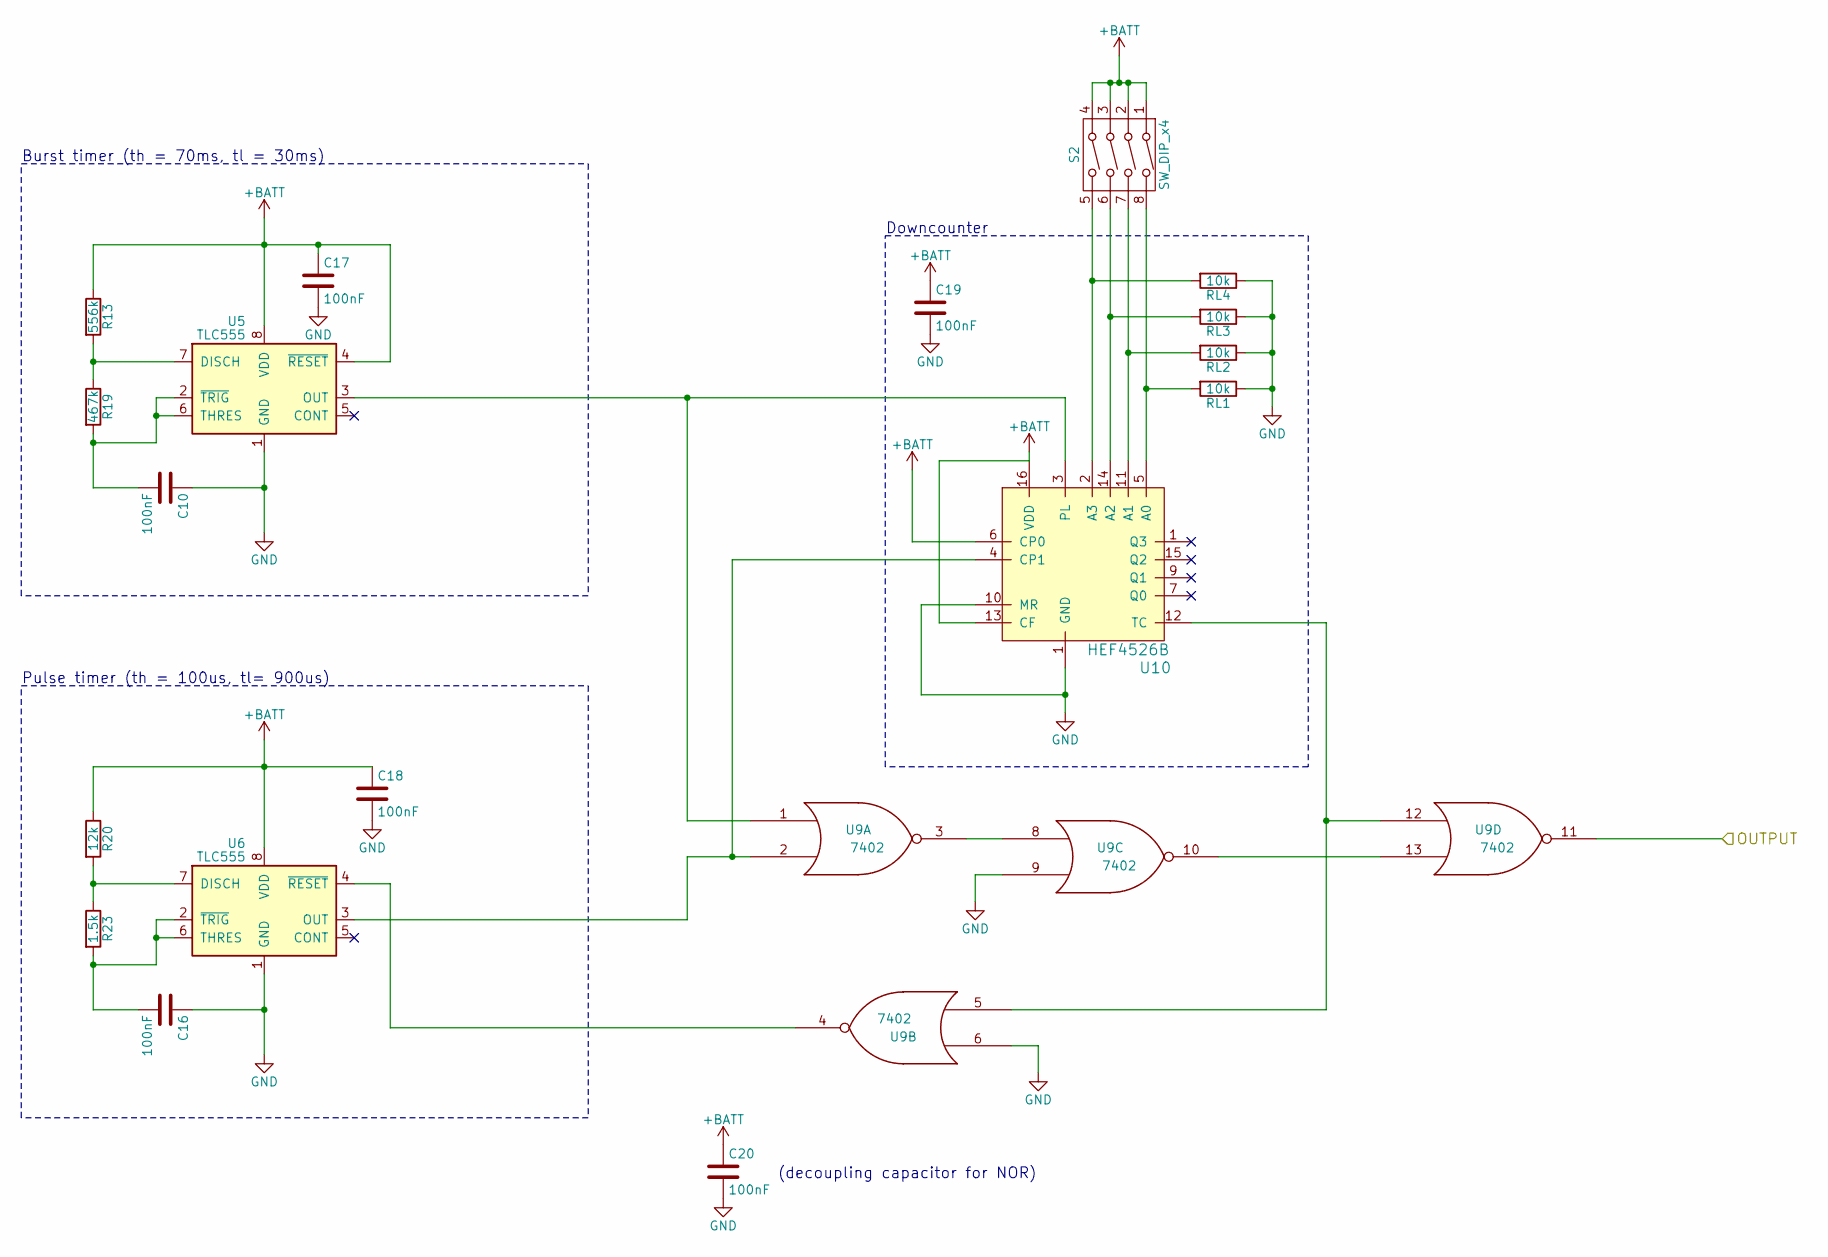
[picture p56: schematic signal_generator.sch]

Parts:
C10, C16, C17, C18, C19, C20: 100nF
R13: 556k
R19: 467k
R20: 12k
R23: 1.5k
RL1, RL2, RL3, RL4: 10k
S2: SW_DIP_x4
U5, U6: TLC555
U9: 7402
U10: HEF4526B

Connections:
+BATT: C17.1, C18.1, C19.1, C20.1, R13.1, R20.1, S2.1, S2.2, S2.3, S2.4, U5.4 (~RESET), U5.8 (VDD), U6.8 (VDD), U10.6 (CP0), U10.13 (CF), U10.16 (VDD)
GND: C10.1, C16.1, C17.2, C18.2, C19.2, C20.2, RL1.1, RL2.1, RL3.1, RL4.1, U5.1 (GND), U6.1 (GND), U9.6, U9.9, U10.1 (GND), U10.10 (MR)
unnamed: C10.2, R19.2, U5.2 (~TRIG), U5.6 (THRES)
unnamed: C16.2, R23.2, U6.2 (~TRIG), U6.6 (THRES)
unnamed: R13.2, R19.1, U5.7 (DISCH)
unnamed: R20.2, R23.1, U6.7 (DISCH)
unnamed: RL1.2, S2.8, U10.5 (A0)
unnamed: RL2.2, S2.7, U10.11 (A1)
unnamed: RL3.2, S2.6, U10.14 (A2)
unnamed: RL4.2, S2.5, U10.2 (A3)
unnamed: U6.4 (~RESET), U9.4
unnamed: U9.3, U9.8
unnamed: U9.10, U9.13
unnamed: U5.3 (OUT), U9.1, U10.3 (PL)
unnamed: U6.3 (OUT), U9.2, U10.4 (CP1)
unnamed: U9.5, U9.12, U10.12 (TC)
OUTPUT: U9.11

Notes on the sheet:
Burst timer (th = 70ms, tl = 30ms)
Downcounter
Pulse timer (th = 100us, tl= 900us)
(decoupling capacitor for NOR)
