VianneyRousset/IRemote/(commit log)

2017-02-22 Add KiCad project
    [IRemote.sch]
2017-03-08 DECODER schema (has not been verified)
    [IRemote.sch]
2017-03-15 add switch pullup
    [IRemote.sch]
2017-05-08 Stage structure schema
2017-05-08 Use hierarchical schematic
    [IRemote.sch, decoder.sch, led_driver.sch, output_driver.sch, recevier_filter.sch, signal_generator.sch]
2017-05-08 Preamp prototype, add IR LED and photodiode
    [led_driver.sch, recevier_filter.sch]
2017-05-08 Preamp & filter proposal
    [recevier_filter.sch]
2017-05-08 Output LED driver
    [output_driver.sch]
2017-05-10 oublie de push
    [_saved_decoder.sch, _saved_led_driver.sch, _saved_signal_generator.sch, signal_generator.sch]
2017-05-10 dont track backup and output files
2017-05-10 remove _saved* files
    [_saved_decoder.sch, _saved_led_driver.sch, _saved_signal_generator.sch]
2017-05-10 restore KiCAD _saved_* data
    [signal_generator.sch]
2017-05-10 led driver MOS, correct opamp
    [IRemote.sch, decoder.sch, led_driver.sch, output_driver.sch, recevier_filter.sch]
2017-05-10 decoder documentation
    [decoder.sch, signal_generator.sch]
2017-05-10 LED driver doc
    [decoder.sch, led_driver.sch]
2017-05-18 fix values of decoder for 1ms period
    [decoder.sch, output_driver.sch]
2017-05-18 correct led driver name
    [decoder.sch]
2017-05-23 some filter modif
    [led_driver.sch, recevier_filter.sch]
2017-05-23 filter and comparator
    [IRemote.sch, decoder.sch, led_driver.sch, output_driver.sch, recevier_filter.sch, signal_generator.sch]
2017-05-24 update opamp connection
    [recevier_filter.sch]
2017-05-31 Reception: schmidt trigger
    [output_driver.sch, recevier_filter.sch]
2017-06-01 Signal generator
    [signal_generator.sch]
2017-06-01 NOR update
    [decoder.sch]
2017-06-01 ouput driver
    [IRemote.sch, decoder.sch, output_driver.sch, signal_generator.sch]
2017-06-09 reannotate schema
    [IRemote.sch, decoder.sch, led_driver.sch, output_driver.sch, recevier_filter.sch, signal_generator.sch]
2017-06-11 update some ref in signal gen
    [signal_generator.sch]
2017-06-11 LED driver++
2017-06-12 Kicad signal generator
    [signal_generator.sch]
2017-06-12 début de Recepteur et filtrage
2017-06-12 LED driver current mesure
2017-06-12 output driver schema
    [output_driver.sch]
2017-06-12 Schematic done
    [IRemote.sch, decoder.sch, led_driver.sch, output_driver.sch, recevier_filter.sch, signal_generator.sch]
2017-06-12 Add filter signal measurement
2017-06-12 paragraph about current to voltage converter and lowpass
2017-06-12 fix schema glitch
    [signal_generator.sch]
2017-06-12 Add missing decoupling capacitors
    [decoder.sch, output_driver.sch, recevier_filter.sch, signal_generator.sch]
2017-06-12 formatting, LED driver schema, references, ...
2017-06-12 schema sheet order
    [IRemote.sch]
2017-06-13 fix schmitt trigger
    [recevier_filter.sch]
